Coal56AB/music_motor/docs/controller-architecture.md

# Музыкальная логика на STM32

STM32F103C8 выбирает до шести нот, отслеживает каналы и sustain, назначает моторы и вычисляет готовую индикацию. Логика индикации перенесена из ESP в `firmware/Core/Inc/display_overview.h` и исполняется только STM32; актуальное правило минимальной видимости описано ниже. ESP32 принимает USB-MIDI, хранит мелодии и рисует полученное состояние без таймеров нот. Компьютер сохраняет редактор и предварительный просмотр; аппаратное воспроизведение отправляет все допущенные настройками ноты, включая кандидатов, не выбранных предварительным просмотром.

Предельная частота STEP — 1200 Гц. Высокие живые ноты переносятся вниз по октавам. При подготовке файла компьютер применяет пользовательские фильтры партий, транспонирование и диапазон, сохраняет CC и ручные назначения. STM32 выполняет окончательный выбор голосов. Нативное ядро ограничено 128 одновременно учитываемыми экземплярами нот, включая педальные хвосты и повторные нажатия. При исчерпании памяти останавливает моторы с ошибкой, а не теряет Note Off.

## Буфер и время

При запуске из памяти ESP передаёт до 4 событий за RPC с учётом кредита STM. Увеличение до 16 вызвало отсутствие ACK на устройстве: допустимый размер пакета не гарантирует обработки MIDI в 3-миллисекундном окне ответа однопроводного UART. После подтверждённого завершённого префикса, покрывающего 500 мс от точки старта, можно запускать поток и пополнять его во время игры. Незавершённая группа MIDI не считается готовым префиксом. Отдельная задержка STM 100 мс сохраняется для предварительной индикации; сканирование диапазона нот файла также остаётся частью подготовки.

Ручные C_START/C_STOP сами включают/выключают ENABLE выбранного мотора. Это единая логика STM32 для терминала и экранчика. Отдельная команда C_ENABLE остаётся для проверки драйвера без STEP; при RESET/SLEEP запуск отклоняется до включения ENABLE.

Studio отправляет ручной START одной командой: ENABLE включается внутри STM перед запуском STEP. После STOP программа дополнительно отправляет C_ENABLE=0 для совместимости со старыми прошивками. C_STREAM_STOP и естественный конец файла всегда снимают ENABLE со всех моторов; прежний флаг «оставить ENABLE» игнорируется. Настройка отключения ENABLE после остановки убрана из интерфейса.

При загрузке/перемотке песни ни Studio, ни ESP не включают ENABLE заранее. STREAM_START оставляет драйверы выключенными во время стартовой задержки и тишины. Каждая команда Note On включает ENABLE непосредственно перед запуском таймера STEP, Note Off снимает его. Подтверждённый display_hold больше не зависит от физического ENABLE: экран может держать обозначение при обесточенном моторе. Для этого поведения обновляются обе прошивки и Studio.

Микрошаг — общая настройка контроллера. Запуск/перемотка песни с ПК и запуск сохранённой песни не отправляют C_MS. Старое поле raw в заголовках песен сохранено для совместимости формата, но при воспроизведении игнорируется. Значение меняется явным выбором в настройках (Studio также применяет свою настройку при подключении).

При назначении новых нот STM32 сохраняет занятые голоса, затем выбирает свободный мотор по расстоянию до его последней высоты, как старый распределитель Studio. Для ещё не использованного мотора расстояние нулевое. Это возвращает участие всех шести моторов в исходной демонстрации Clockwork при разрешённых M1–M6; сами ноты демонстрации не изменены.

Для файлов в режиме «Стабильное распределение» используется `file_assignment.h`: независимые экземпляры нот, включая унисоны разных партий, приоритеты по громкости/времени начала и перестановки назначения как в старом `allocator.place`. Clockwork сравнивается с прежним распределителем по каждому переключению всех шести моторов при пользовательском лимите полифонии 4, а не только по множеству задействованных моторов. Живой MIDI продолжает использовать отдельный алгоритм отбора высот.

Вместо двух больших музыкальных состояний STM32 использует один планировщик, работающий впереди воспроизведения. Принимает MIDI-события, выбирает голоса и помещает рассчитанные переключения в очередь из 512 записей по 8 байт (4096 байт). Частоты и времена хранятся без дополнительного округления. Маркеры времени сохраняют информацию о тишине. События исполняются по часам STM32, а не по моменту прихода пакета.

Компьютер старается наполнить очередь на 1,5 секунды вперёд; ESP перед стартом набирает до 2 секунд либо до исчерпания доступной ёмкости, затем пополняет все доступные места пакетами не более четырёх MIDI-событий. При заполненной очереди свободные места проверяются каждые 10 мс. ESP и Studio запрашивают ёмкость через C_QUEUE после очистки, поддерживая прежние контроллеры с 256 записями. Время покрытия зависит от плотности событий: фиксированная память не гарантирует 2 секунды на произвольном MIDI. Отсутствие будущей ноты в буфере не отменяет сглаживание индикации на STM32. Пустая очередь во время воспроизведения вызывает остановку с `E_UNDERRUN`.

При отпускании звучащего мотора STM32 ищет следующее назначение именно этому мотору. Если интервал не больше 500 мс, выставляет `display_hold`. STEP уже остановлен; экран сохраняет обозначение. При остановке, ошибке или потере связи удержание снимается. В живом MIDI будущего нет, поэтому `display_hold` не используется.

Для файлового/очередного воспроизведения минимальная длительность индикации равна 1000 мс от начала ноты. При длинной паузе нота, звучавшая не меньше секунды, гаснет сразу после отпускания; короткая остаётся только до `время начала + 1000`. Дополнительной секунды после отпускания нет. Началом считается включение или смена отображаемой ноты; подтверждённый `display_hold` сохраняет подсветку короткого промежутка. Сброс, сон, остановка и потеря связи гасят индикацию. На STEP и MIDI-график это сглаживание не влияет. Тесты проверяют короткие/длинные ноты, переполнение часов и передачу 100 000 готовых состояний STM на ESP. Старый алгоритм с дополнительной секундой изменён по запросу пользователя.

STATE v2 (86 байт) передаётся с интервалом 20 мс: первые 50 байт содержат фактическое состояние (version=2), следующие 36 — шесть готовых отображаемых записей `flags:u8, note:u8, frequency_mHz:u32`. Bit1 отображаемой записи означает подсветку, а не STEP. STM32 обновляет сглаживание при подготовке STATE; видимый момент изменения ограничен периодом передачи и временем доставки. ESP хранит эти значения до следующего STATE, кроме сброса при потере связи/смене источника. Нужно обновить обе платы. C_STATUS для ПК остаётся прежним; его данные не подменены отображаемыми.

## Формат событий

Базовый UART-протокол с CRC и ACK сохранён. Новые команды:

| Команда | Назначение |
|---|---|
| 22 `RAW_EVENTS` | Пакет MIDI-событий по 10 байт; ACK возвращает число доступных входных событий |
| 23 `RAW_SEEK` | 32-битная позиция перемотки в мс; до передачи событий, после CLEAR |
| 0x56 / 0x57 | Живые MIDI-события от ESP / подтверждение STM |

Запись: `uint32 time_ms`, `uint8 address`, `uint8 type`, `uint8 note`, `uint8 velocity`, `uint8 pin`, `uint8 priority`. Address содержит номер MIDI-порта в старших четырёх битах и канал в младших. Pin: 0 — автоматическое назначение; 1..6 — мотор. Priority 0..127 задаёт порядок редакторской партии для стратегии «Выбранные партии»; у живого MIDI, конфигурации, CC и конца файла он равен нулю.

Младшие семь бит type: 0 — Note On; 1 — Note Off; 2 — CC; 3 — конец файла; 4 — сброс живого MIDI; 5 — конфигурация файла. Старший бит завершает группу одновременных событий. Выбор выполняется после всей группы, даже если она разделена между пакетами. У конфигурации address — маска моторов, note — полифония 1..6, velocity — код стратегии. Конфигурация идёт первой, в момент 0. Конец файла — type 0x83, остальные поля нулевые.

На один входной MIDI-элемент резервируется до 13 выходных записей: шесть отпусканий, шесть включений и маркер. Дополнительный резерв нужен для восстановления при перемотке. Кредит рассчитывается как `max(0, floor((256-used)/13)-1)`. Отправитель передаёт не больше объявленного кредита. Неполный или неверный пакет отклоняется до изменения состояния; переполнение внутреннего пула нот приводит к явной остановке.

Для перемотки отправитель повторяет исходные события от начала, сохраняя абсолютные времена. STM32 анализирует префикс без STEP, восстанавливает состояние на границе перемотки и планирует оставшуюся часть относительно неё. ESP32 не вычисляет удержанные ноты.

Живой пакет содержит флаг подключения в первом байте и затем записи по 10 байт. ESP хранит неподтверждённый пакет и повторяет его с тем же номером. STM распознаёт повтор по полному содержимому и номеру: повторная доставка не создаёт дополнительного нажатия. Переполнение входной очереди ESP вызывает сброс музыкального состояния. Пока двигателями управляет компьютер или проигрыватель файла, живой источник получает ответ «занято».

## Совместимость и проверка

`SONG_BEGIN` длиной 49 байт с последним байтом 1 сохраняет новый формат. Заголовок Flash сохраняет прежний размер 64 байта; reserved=1 обозначает MIDI-события, reserved=0 — старые команды моторам. Новая ESP умеет читать оба формата. Старые файлы с частотой выше 1200 Гц надо сохранить заново. Симулятор ПК продолжает использовать предварительно рассчитанные команды; фактическое распределение на оборудовании и предварительный просмотр могут различаться.

Обе прошивки и программу ПК нужно обновлять вместе. Сборки не прошивают устройства и не запускают моторы. Перед испытанием проверяются нативные тесты реального `engine.c`: кольцевая очередь, sustain, перемотка, группы событий, выбор голосов, короткие паузы, тайм-аут и некорректные пакеты. Проверка времени обработки и джиттера STEP на физической плате остаётся отдельным измерением.
## Предварительная индикация

STATE v3 расширяет v2 до 94 байт: время STM `u32` по смещению 86 и поколение воспроизведения `u32` по смещению 90. ESP принимает также v1/v2. Пакет 0x45 содержит поколение `u32`, число записей `u8` и до 16 записей `at_STM:u32, motor:u8, note:u8, frequency_mHz:u32`. STM каждые 20 мс просматривает только уже назначенные выходные события ближайших 100 мс. Это не повторный анализ MIDI на ESP и не изменение времени STEP.

ESP хранит будущие включения индикаторов и исполняет их по времени STM. Смещение часов оценивается по минимальной наблюдаемой разнице времени приёма и метки STM в текущем поколении; задержка транспорта и LCD полностью не исключается. Запоздалый STATE не отменяет уже исполненное будущее включение. Начало, остановка и перемотка меняют поколение; смена источника также очищает очередь ESP. Выключение индикаторов по-прежнему рассчитывает STM прежним алгоритмом сглаживания. Живой MIDI и ноты, ещё не попавшие в буфер STM, заранее не предсказываются.

## Параметры и аккорд инициализации

ESP хранит подтверждённый STM микрошаг в записи настроек экрана (версия 2, CRC). Запись выполняется, как и для экрана, после 5 секунд без изменений, когда моторы остановлены. При загрузке ESP отправляет сохранённый шаг и ждёт подтверждения состояния до автоматической проверки моторов. Настройки версии 1 сохраняют свои параметры экрана; неверный CRC игнорируется. При подключённом ПК его настройки имеют приоритет.

Отрисовка узких индикаторов ограничена числом пикселей в буфере, а не фиксированными 16 строками: область 75×48 рисуется за один проход вместо трёх. Это не меняет временное сглаживание индикаторов на STM и не является предварительным планированием изображения.

STM последовательно добавляет C2–G3–E4–A4–D5–G5 с интервалом 400 мс. После вступления шестого мотора полный аккорд звучит 2000 мс, затем частоты линейно снижаются к 20 Гц за 400 мс с обновлением каждые 10 мс. После торможения STEP и ENABLE отключаются. От первой ноты до остановки проходит 4400 мс; экран ESP учитывает эту длительность. Принудительный стоп прерывает проверку и торможение немедленно.

## Независимость обмена от MIDI-графика ESP

Задача `song-control` на ядре 1 (приоритет 8) владеет разбором ACK, загрузкой
мелодии, пополнением STM, heartbeat и состоянием `control::Link`. Физический UART
по-прежнему обслуживает `stm-link` с приоритетом 21. LCD и touch работают в `hmi`
на ядре 0. `hmi_module_run` запускается после инициализации дисплея.

`ui_bridge` передаёт UI снимки каталога/состояния и до 128 полных графических
пакетов. Mutex удерживается только для копирования; экранные функции никогда не
вызываются под ним. Если UI надолго отстал, старая графическая история сбрасывается
и восстанавливается из следующих состояний. Поток нот не ждёт освобождения
экранной очереди. ACK экранного действия хранится отдельно и не вытесняется
телеметрией. Повтор команды запуска после задержки UI не переключает песню повторно.

Тест `native_ui_bridge_test.cpp` намеренно блокирует потребителя и проверяет,
что другой поток завершает публикацию 10 000 пакетов, сохраняет ACK/ошибку и
корректно обрабатывает смену источника и остановку. Это проверка синхронизации;
нагрузка на SPI и реальные интервалы задач проверяются на ESP.

UART-драйвер теперь устанавливается внутри `stm-link`: его ISR тоже получает
ядро 1, а не ядро UI, запустившее инициализацию. RX FIFO threshold — 32 байта,
RX timeout — 2 символа. USB role detection ждёт максимум 100 мс, завершаясь
раньше при обнаружении подключения. Обнаружение ПК после холодного включения
с таким коротким окном необходимо проверить на реальном USB-хосте.

История графика увеличена с 96 до 1024 записей. Открытые ноты не вытесняются;
при заполнении удаляется закрытая нота с наиболее старым окончанием. Предсказание,
которое старше последнего авторитетного STATE, не может снова зажечь столбик.

`desktop/tests/stress_saved_playback.py` проверяет реальный `song_store.cpp`,
`controller_link.cpp`, STM protocol/engine, ограниченные очереди и фрагментацию
ответов при 460800 baud. 200 прогонов пяти песен прошли без E10 и переполнения
TX: задержка ответа 1/10 мс, потери 0/10/25%, по 10 случайных последовательностей.
UI-потребитель в этой модели не обслуживается; отдельный threaded bridge test
проверяет отсутствие блокировки отправителя при зависшем UI. Это не измерение
запаса CPU на плате. Диагностический прогон с искусственными 50 мс на каждый обмен
воспроизводит E10: бесконечную задержку транспорта конечный буфер не компенсирует.

## Ответ до подготовки телеметрии

После повторной ошибки на устройстве найдено неучтённое моделью ограничение:
`protocol_esp_byte` вызывал `hmi_poll(1)` перед выдачей ответа. Расчёт preview и
истории входил в прежнее окно 3 мс. Теперь STM сначала формирует и запускает
ответ, затем готовит телеметрию для следующего обмена. Дополнительное ожидание
1 мс убрано: ESP сохраняет RX включённым во время TX и фильтрует эхо.
Согласованные параметры обеих плат: начало ответа не позднее 12 мс после запроса,
тайм-аут master 30 мс (запрос и ответ занимают суммарно менее 11 мс).
Просроченный запрос больше не очищает оставшуюся очередь ответов/телеметрии.

Регрессия `native_reply_order_test.c` вставляет 20 мс задержки в создание STATE
и проверяет, что вызов отправки ответа уже произошёл до неё. 200 прогонов песен
повторены с новым тайм-аутом; 33 теста desktop и 11 USB-симулятора прошли.
Исправления требуют перепрошивки STM и ESP вместе. Реальные интервалы выполнения
STM этим тестом не измеряются; отсутствие ошибок на плате ещё нужно подтвердить.

## Перегрузка телеметрии и диагностика живого MIDI

Очередь TX STM (`esp_tx_queue.h`) резервирует 64 байта под ACK (максимальный
ответ статуса — 61 байт). Отказ добавить экранный пакет больше не устанавливает
ошибку RX и не очищает входящие байты. Обе стороны этой очереди обслуживает
основной цикл, поэтому копирование не выключает прерывания STEP/UART; ISR
передаёт отдельный буфер HD-ответа.

`native_esp_tx_test.c`: 10 миллионов попыток добавить телеметрию, все ACK сохранены.
`native_live_spam_test.c`: 20 000 событий, переполнение номера последовательности,
30 секунд удержания одной ноты после потока и Note Off. 200 прогонов сохранённых
песен повторены с настоящей реализацией очереди TX, без переполнений и E10.
Это проверки кода; электрические потери UART и реальные времена ISR не моделируются.

ESP отправляет USB-симулятору пакет 0x61 с шестью uint32: запросы, ответы,
тайм-ауты, отброшенные RX-ответы, максимальная длительность обмена в микросекундах,
отказы очереди TX. Публикация выполняется задачей обмена раз в 500 мс и не зависит
от LCD. Симулятор показывает счётчики и убирает старую ошибку после переподключения.

На вкладке MIDI название выводится как `MIDI: <iProduct>` вместо сообщения о
подключении; отсутствие USB-названия заменяется на `USB MIDI`. Для симулятора —
`MIDI: USB-симулятор`. Имя хранится отдельно от очереди графика и переживает смену
источника и сброс отставшей отрисовки. Строка состояния не меняется.

## Текущие настройки отображения и курсора

Минимальное отображение ноты уменьшено до 200 мс от её начала. Удержание до
следующей известной ноты с паузой до 500 мс сохранено. Длительности STEP не меняются.
Например, нота длиной 600 мс перед паузой 600 мс теперь гаснет при окончании ноты,
а нота длиной 100 мс без ближайшего продолжения отображается до 200 мс.

В MIDI-редакторе одиночный левый щелчок в поле (включая ноты) устанавливает курсор
с привязкой к выбранной сетке. Решение принимается при отпускании кнопки:
перетаскивание нот, изменение длительности, выделение рамкой и Ctrl-выделение
не перемещают курсор. Установка курсора через верхнюю линейку сохранена.
