Coal56AB/music_motor/Songs/SOURCES.md

# Источники и обработка

## Рахманинов

Музыкальные данные двух прелюдий и их переложения в этой папке распространяются
по [CC BY-SA 4.0](https://creativecommons.org/licenses/by-sa/4.0/).

- **Прелюдия до-диез минор, op. 3 № 2**: Сергей Рахманинов; нотный набор Petro Kostandy,
  Mutopia-2015/07/09-2033. [Источник](https://www.mutopiaproject.org/cgibin/piece-info.cgi?id=2033).
  Издания Bosworth & Co. 1896 и Universal Edition 1910. Сохранены все разделы.
  Темп адаптирован: начальные низкие ноты (доли 0–6) — исходные 60 BPM,
  обе аккордовые части (6–54 и 178–218) — 50 BPM.
  Два протяжённых переходных аккорда после перебора (170–178) — 100 BPM.
  Перебор (54–170) и аутро (218–246) сохраняют исходные 192 и 62 BPM.
  Первые два звука вступления удлинены с 1 до 1,5 секунды каждый;
  третий начинается на секунду позже и заканчивается в исходный момент.
- **Прелюдия соль минор, op. 23 № 5**: Сергей Рахманинов; нотный набор Joram Berger,
  Mutopia-2015/09/28-2001. [Источник](https://www.mutopiaproject.org/cgibin/piece-info.cgi?id=2001).
  Взята первая маршевая часть до Un poco meno mosso (132 четвертные доли),
  добавлен заключительный аккорд соль минор.

Изменения для моторов: выбор максимум шести одновременно звучащих нот с приоритетом
мелодии и баса; перенос недоступных нот по октавам в диапазон 20–1200 Гц;
явные назначения M1–M6. Исходные MIDI и LilyPond сохранены в `sources/`.
Набор нот и паузы взяты из источников; изменения темпа указаны выше.
Это не запись исполнения пианиста.
Указание авторов не означает их одобрения этого переложения.

## Polyphia

Источник двух основных голосов — предоставленные пользователем массивы
`sources/polyphia_user_notes.txt`. Это фрагменты Playing God и O.D., расширенные
четырьмя разделами: исходный рифф, украшенная вариация, новая средняя часть
на начальном мотиве и возврат риффа с украшениями. Дополнительно вступают
арпеджио, синкопы, ответы и верхний голос.
Дополнительные партии и финал — новая аранжировка, а не восстановление полной записи группы.

Принятые допущения: ДО1 = C4, ДО0 = C3, СИ00 = B2; каждый исходный голос идёт
по собственным длительностям. Высокая мелодия Playing God перенесена целиком
на две октавы вниз; внутренние интервалы сохранены. Длительности звучания составляют
90% записанного шага для раздельных атак. Темпы аранжировок: Playing God 112 BPM,
O.D. 128 BPM. Это выбранные темпы для моторов, не заявленные темпы оригинальных записей.

## Имперский марш

Тема Джона Уильямса; новая моторная аранжировка. Высокое продолжение сверено
с [разбором и нотным фрагментом Music for Music Teachers](https://www.music-for-music-teachers.com/imperial-march-star-wars.html).
Форма: основная тема, высокое продолжение, его вариант с переходом, возвращение темы,
заключительный аккорд. Это переложение темы, не полная оркестровая партитура.

Пересоздание файлов: `python desktop/tools/build_music_examples.py`.
