Coal56AB/music_motor/Songs/sources/polyphia_user_notes.txt

static const MelodyStep_t Polyphia_OD_Notes[] = {
	// Второй голос: бас O.D., такты 41-44 и первая восьмая 45-го.
	// Заглушенные ноты (X) передаются паузами.
	// 1 ТАКТ / БАС: 41 ТАКТ
	{{FA1s, NOTE_SIXTEENTH}, {FA0s, NOTE_SIXTEENTH}},
	{{LA1, NOTE_SIXTEENTH}, {LA0, NOTE_SIXTEENTH}},
	{{DO2s, NOTE_SIXTEENTH}, {DO1s, NOTE_SIXTEENTH}},
	{{FA2s, NOTE_SIXTEENTH}, {FA1s, NOTE_SIXTEENTH}},
	{{NOTE_REST, NOTE_QUARTER}, {NOTE_REST, NOTE_QUARTER}},
  
	{{FA1s, NOTE_SIXTEENTH}, {NOTE_REST, NOTE_SIXTEENTH}},
	{{LA1, NOTE_SIXTEENTH}, {NOTE_REST, NOTE_SIXTEENTH}},
	{{DO2s, NOTE_SIXTEENTH}, {NOTE_REST, NOTE_SIXTEENTH}},
	{{RE2, NOTE_SIXTEENTH}, {NOTE_REST, NOTE_SIXTEENTH}},
	{{FA1, NOTE_SIXTEENTH}, {FA0, NOTE_SIXTEENTH}},
	{{SOL1s, NOTE_SIXTEENTH}, {FA0, NOTE_SIXTEENTH}},
	{{SI1, NOTE_SIXTEENTH}, {FA0, NOTE_SIXTEENTH}},
	{{FA2s, NOTE_SIXTEENTH}, {FA0, NOTE_SIXTEENTH}},

	// 2 ТАКТ / БАС: 42 ТАКТ
	{{FA2s, NOTE_SIXTEENTH}, {FA1, NOTE_SIXTEENTH}},
	{{SOL2s, NOTE_SIXTEENTH}, {FA1, NOTE_SIXTEENTH}},
	{{RE2, NOTE_SIXTEENTH}, {FA0, NOTE_SIXTEENTH}},
	{{SI1, NOTE_SIXTEENTH}, {FA0, NOTE_SIXTEENTH}},
	{{DO1s, NOTE_SIXTEENTH}, {FA0, NOTE_SIXTEENTH}},
	{{FA1, NOTE_SIXTEENTH}, {FA0, NOTE_SIXTEENTH}},
	{{SOL1s, NOTE_SIXTEENTH}, {NOTE_REST, NOTE_SIXTEENTH}},
	{{DO2s, NOTE_SIXTEENTH}, {NOTE_REST, NOTE_SIXTEENTH}},
	{{FA2, NOTE_THIRTYSECOND}, {NOTE_REST, NOTE_THIRTYSECOND}},
	{{FA2s, NOTE_THIRTYSECOND}, {NOTE_REST, NOTE_THIRTYSECOND}},
	{{FA2, NOTE_SIXTEENTH}, {NOTE_REST, NOTE_SIXTEENTH}},
	{{DO2s, NOTE_SIXTEENTH}, {NOTE_REST, NOTE_SIXTEENTH}},
	{{SI1, NOTE_SIXTEENTH}, {NOTE_REST, NOTE_SIXTEENTH}},
	{{SOL1s, NOTE_SIXTEENTH}, {NOTE_REST, NOTE_SIXTEENTH}},
	{{FA1, NOTE_SIXTEENTH}, {NOTE_REST, NOTE_SIXTEENTH}},
	{{DO3s, NOTE_SIXTEENTH}, {NOTE_REST, NOTE_SIXTEENTH}},

	// 3 ТАКТ / БАС: 43 ТАКТ
	{{FA1s, NOTE_SIXTEENTH}, {FA0s, NOTE_SIXTEENTH}},
	{{LA1, NOTE_SIXTEENTH}, {LA0, NOTE_SIXTEENTH}},
	{{DO2s, NOTE_SIXTEENTH}, {DO1s, NOTE_SIXTEENTH}},
	{{FA2s, NOTE_SIXTEENTH}, {FA1s, NOTE_SIXTEENTH}},  
	{{NOTE_REST, NOTE_QUARTER}, {NOTE_REST, NOTE_QUARTER}},
  
	{{FA1s, NOTE_SIXTEENTH}, {FA0s, NOTE_SIXTEENTH}},
	{{LA1, NOTE_SIXTEENTH}, {FA0s, NOTE_SIXTEENTH}},
	{{DO2s, NOTE_SIXTEENTH}, {FA0s, NOTE_SIXTEENTH}},
	{{RE2, NOTE_SIXTEENTH}, {FA0s, NOTE_SIXTEENTH}},
	{{FA1, NOTE_SIXTEENTH}, {FA0, NOTE_SIXTEENTH}},
	{{SOL1s, NOTE_SIXTEENTH}, {FA0, NOTE_SIXTEENTH}},
	{{SI1, NOTE_SIXTEENTH}, {FA0, NOTE_SIXTEENTH}},
	{{FA2s, NOTE_EIGHTH}, {FA0, NOTE_EIGHTH}},

	// 4 ТАКТ / БАС: 44 ТАКТ
	{{SOL2s, NOTE_SIXTEENTH}, {FA0, NOTE_SIXTEENTH}},
	{{RE2, NOTE_SIXTEENTH}, {FA0, NOTE_SIXTEENTH}},
	{{SI1, NOTE_SIXTEENTH}, {NOTE_REST, NOTE_SIXTEENTH}},
	{{LA1, NOTE_SIXTEENTH}, {FA0, NOTE_SIXTEENTH}},
	{{DO3s, NOTE_SIXTEENTH}, {FA0, NOTE_SIXTEENTH}},
	{{FA2s, NOTE_SIXTEENTH}, {FA0, NOTE_SIXTEENTH}},
	{{LA2, NOTE_SIXTEENTH}, {NOTE_REST, NOTE_SIXTEENTH}},
	{{SI1, NOTE_SIXTEENTH}, {NOTE_REST, NOTE_SIXTEENTH}},
	{{SI0, NOTE_SIXTEENTH}, {NOTE_REST, NOTE_SIXTEENTH}},
	{{RE2, NOTE_SIXTEENTH}, {FA0s, NOTE_SIXTEENTH}},
	{{SOL2s, NOTE_SIXTEENTH}, {FA0s, NOTE_SIXTEENTH}},
	{{LA1, NOTE_SIXTEENTH}, {DO1s, NOTE_SIXTEENTH}},
	{{DO1s, NOTE_SIXTEENTH}, {DO1s, NOTE_SIXTEENTH}},
	{{LA2, NOTE_SIXTEENTH}, {SI00, NOTE_SIXTEENTH}},
	{{FA2s, NOTE_SIXTEENTH}, {NOTE_REST, NOTE_SIXTEENTH}},

	// 5 ТАКТ / БАС: НАЧАЛО 45 ТАКТА
	{{SI1, NOTE_SIXTEENTH}, {SI00, NOTE_SIXTEENTH}},
	{{RE2, NOTE_SIXTEENTH}, {SI00, NOTE_SIXTEENTH}},
	{{FA2s, NOTE_SIXTEENTH}, {SI00, NOTE_SIXTEENTH}},
	{{SI2, NOTE_SIXTEENTH}, {SI00, NOTE_SIXTEENTH}}
};
static Melody_t Polyphia_OD = {
	song_length(Polyphia_OD_Notes), Polyphia_OD_Notes, {10U, 2U}
};

static const MelodyStep_t Polyphia_PlayingGod_Notes[] = {
	//1 ТАКТ
	{{SOL2, NOTE_QUARTER}, {MI0, NOTE_EIGHTH}},
	{{MI3, NOTE_EIGHTH}, {MI0, NOTE_EIGHTH}},
	{{SI3, NOTE_EIGHTH}, {MI0, NOTE_EIGHTH}},
	{{MI4, NOTE_EIGHTH}, {MI0, NOTE_EIGHTH}},
	{{SI3, NOTE_EIGHTH}, {NOTE_REST, NOTE_EIGHTH}},
	{{SOL3, NOTE_EIGHTH}, {NOTE_REST, NOTE_EIGHTH}},
	{{SI3, NOTE_EIGHTH}, {MI0, NOTE_EIGHTH}},
	{{DO4, NOTE_EIGHTH_DOT}, {MI0, NOTE_EIGHTH}},
	{{LA3, NOTE_SIXTEENTH}, {DO1, NOTE_EIGHTH}},
	{{SI3, NOTE_EIGHTH}, {DO1, NOTE_EIGHTH}},
	{{SI2, NOTE_EIGHTH_DOT}, {DO0, NOTE_EIGHTH}},
	{{DO2, NOTE_SIXTEENTH}, {DO0, NOTE_EIGHTH}},
	{{SI3, NOTE_EIGHTH}, {NOTE_REST, NOTE_EIGHTH}},
	{{MI3, NOTE_QUARTER}, {NOTE_REST, NOTE_EIGHTH}},
	
	//2 ТАКТ
	{{RE3s, NOTE_QUARTER}, {NOTE_REST, NOTE_EIGHTH}},
	{{SI2, NOTE_EIGHTH}, {MI1, NOTE_SIXTEENTH}},
	{{LA2, NOTE_EIGHTH}, {MI1, NOTE_SIXTEENTH}},
	{{LA3, NOTE_EIGHTH}, {SI00, NOTE_EIGHTH}},
	{{SI3, NOTE_SIXTEENTH}, {SI00, NOTE_EIGHTH}},
	{{LA3, NOTE_EIGHTH}, {SI00, NOTE_EIGHTH}},
	{{RE3, NOTE_SIXTEENTH}, {SI00, NOTE_EIGHTH}},
	{{FA4s, NOTE_SIXTEENTH}, {NOTE_REST, NOTE_EIGHTH}},
	{{LA4, NOTE_SIXTEENTH}, {NOTE_REST, NOTE_EIGHTH}},
	{{RE3s, NOTE_EIGHTH}, {LA0, NOTE_EIGHTH}},
	{{LA3, NOTE_SIXTEENTH}, {LA0, NOTE_SIXTEENTH}},
	{{RE3s, NOTE_EIGHTH}, {LA0, NOTE_SIXTEENTH}},
	
	{{SI4, NOTE_SIXTEENTH}, {SI00, NOTE_EIGHTH}},
	{{FA4s, NOTE_SIXTEENTH}, {SI00, NOTE_EIGHTH}},
	{{RE3s, NOTE_THIRTYSECOND}, {SI00, NOTE_EIGHTH}},
	{{NOTE_REST, NOTE_THIRTYSECOND}, {SI00, NOTE_EIGHTH}},
	{{RE3s, NOTE_EIGHTH}, {SOL0, NOTE_EIGHTH_TRIPLET}},
	{{MI3, NOTE_EIGHTH}, {SOL0, NOTE_EIGHTH_TRIPLET}},
	
	{{DO3, NOTE_SIXTEENTH}, {SI0, NOTE_QUARTER_TRIPLET}},
	{{SI2, NOTE_SIXTEENTH}, {SOL0, NOTE_EIGHTH_TRIPLET}},
	{{MI3, NOTE_SIXTEENTH}, {SOL0, NOTE_EIGHTH_TRIPLET}},
};
