Coal56AB/music_motor/docs/images/music-motor-studio_midi.png

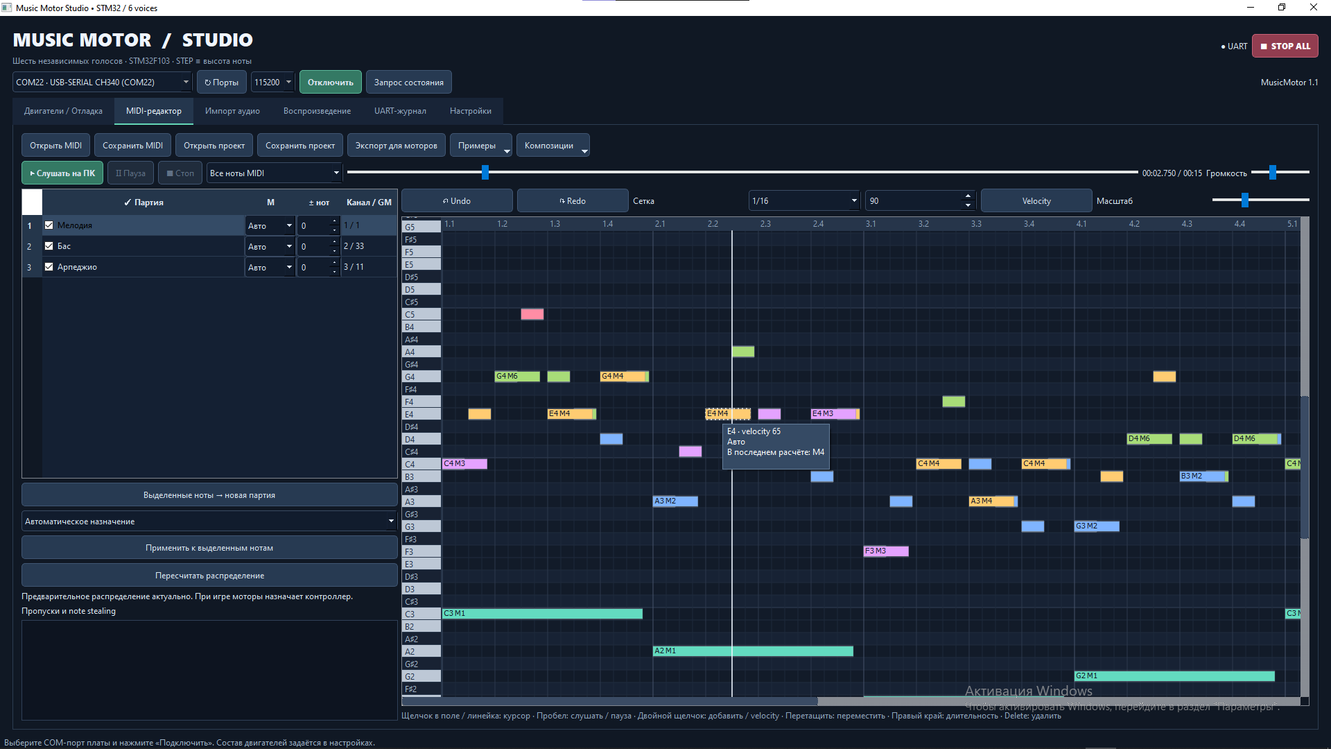
docs/images/music-motor-studio_midi.png
