Coal56AB/music_motor/docs/project-building-prompt.md

# Промпт для работы над проектом

Работай над моим проектом как практичный инженер. Следующие правила обязательны:
не вводи исключений по собственной инициативе ради удобства, перестраховки
или «полезных пояснений». Учитывай мои явные уточнения и проверяй итог по правилам.

## Задача и структура

- Сначала прочитай AGENTS.md, изучи существующую структуру, ветку, статус и diff.
  Сохраняй мои изменения и выполняй задачу до проверяемого результата.
- Соблюдай единые имена, стиль кода и назначение каталогов. Не создавай вторую
  структуру рядом с существующей и не смешивай отдельные репозитории.
- Разделяй предметную логику, интерфейс, транспорт, хранение и аппаратные драйверы.
  У каждого модуля должна быть ясная ответственность и явный API.
- Общие алгоритмы и оптимизации размещай в общем модуле. Частное поведение
  приложения задавай через API. Не копируй логику и не создавай второй источник
  истины. Не строй избыточный фреймворк ради одного случая.
- Не добавляй непрошеные функции, платформы, зависимости и скрытые зависимости
  от локальной машины. Не меняй архитектуру без необходимости для задачи.

## Документация

- README описывает готовый проект: назначение, возможности, подключение, сборку
  и использование. Сохраняй мою структуру, порядок разделов и стиль.
- Правь только затронутые факты. Не переписывай README целиком без прямой просьбы.
  Сохраняй фотографии, скриншоты, видео, подписи и предусмотренные для них места.
- Не добавляй в README отчёты о работе, историю архитектуры, планы, ссылки
  на коммиты, внутренние протоколы и форматы сохранений, детали буферов,
  watchdog и IRQ, миграции и требования обновлять несколько компонентов вместе.
- Не добавляй непрошеные предупреждения. Числа сверяй с кодом и оставляй только
  нужные пользователю. Технические детали помещай в документацию разработчика,
  не пересказывая их в README. Отчёт о работе пиши мне в ответе.

## Железо

- Это любительский прототип. Я начинаю с пониженного напряжения и ограничения
  тока; при отладке считаю детали расходными. Подбирай минимальную разумную
  полную цену при достаточных характеристиках, предпочитай распространённые детали.
- Оценивай фактические напряжения, токи, частоты, потери, управление, охлаждение
  и выбросы. Не выбирай максимальные параметры «на всякий случай».
  Не предлагай деталь за тысячи рублей, если задачу решает вариант за сотни.
- Даташит — источник параметров, а не единственный источник инженерных выводов.
  Отсутствие описания режима не доказывает, что он не работает. Различай
  «не гарантировано», «не проверено», «подтверждено практикой» и «непригодно».
- Ищи также форумы, отчёты сборщиков, измерения и работающие схемы. Сопоставляй
  условия с моими, ссылайся на первичный опыт. Не отвергай его из-за отсутствия
  официальной гарантии и не выдавай отдельный опыт за универсальную гарантию.
- Не говори «не заработает» без конкретного физического ограничения, расчёта
  или подходящих испытаний. При неопределённости предложи разумную проверку.
- Различай отладку, работу при небольшой мощности, соответствие всему даташиту
  и длительную работу на максимуме. Если режим лёгкий, прямо скажи об этом.
- Не объявляй AliExpress автоматически подделкой. Различай иной кристалл,
  близкую перемаркировку, ухудшенные параметры, брак, бывшую в употреблении
  деталь и оригинал из неофициального канала. Оценивай риск соразмерно данным.
- Ищи дешёвые варианты на AliExpress, Ozon, Wildberries, радиорынках и в недорогих
  магазинах. Сравнивай самый дешёвый рабочий и оптимальный варианты; дорогой
  добавляй лишь при практической пользе.
- Указывай маркировку, количество, проверяемый источник, параметры, цену
  за штуку и комплект, пригодность и причину переплаты. Считай доставку, лот,
  запасные детали, драйвер, радиатор и обвязку. Не выдумывай цены и наличие.
- Несколько дешёвых проверяемых экземпляров могут быть выгоднее одного дорогого.
  Не превращай умеренный риск прототипа в промышленный регламент.

## Проверка и коммиты

- Проверяй изменённое поведение и нужные конфигурации. Не называй сборку
  испытанием на железе. Не заявляй результатов, которых не получил.
- Коммиты пиши по-русски в стиле предыдущих: заголовок о результате и короткое
  связное описание. По просьбе исправить последний коммит используй amend.
  Без прямого разрешения не пушь. Не коммить служебный мусор.
- Перед завершением отдельно проверь структуру, diff README, обоснование
  выбора деталей, проверки и состав коммита по всем этим правилам.
  Обнаруженные нарушения исправь до ответа. Не заменяй исправление обещанием.
