Coal56AB/music_motor/desktop/app/main_window.py

import copy
import datetime
import struct
import time
from pathlib import Path
from PySide2.QtCore import Qt, QTimer, QObject, QThread, Signal
from PySide2.QtWidgets import (
    QMainWindow,
    QWidget,
    QVBoxLayout,
    QHBoxLayout,
    QGridLayout,
    QLabel,
    QPushButton,
    QComboBox,
    QCheckBox,
    QTabWidget,
    QGroupBox,
    QScrollArea,
    QSplitter,
    QTableWidget,
    QTableWidgetItem,
    QHeaderView,
    QFileDialog,
    QMessageBox,
    QSpinBox,
    QDoubleSpinBox,
    QSlider,
    QPlainTextEdit,
    QProgressBar,
    QFormLayout,
    QLineEdit,
    QInputDialog,
    QShortcut,
    QMenu,
    QFrame,
)
from serial.tools import list_ports
from app.settings import load_settings, save_settings, ROOT, songs_directory
from app.music_math import MICROSTEPS, note_name, note_frequency
from app.playback import StreamPlayer, short_gap_note
from app.device_songs import DeviceSongs
from app.theme import STYLE
from widgets.motor_card import MotorCard
from widgets.midi_overview import MidiOverview
from widgets.piano_roll import PianoRoll, NoteItem
from protocol.client import Client
from protocol.wire import Command as C, Error
from midi.model import load_midi, save_midi, demo_song, save_project, load_project, Part, Song, Note
from midi.library import discover_songs
from midi.allocator import allocate, pin_conflict_spans, STRATEGIES, MOTOR_COLORS
from audio.transcribe import transcribe
from audio.preview import PreviewPlayer, preview_notes


def button(text, slot, kind=None):
    b = QPushButton(text)
    b.clicked.connect(slot)
    if kind:
        b.setObjectName(kind)
    return b


def spin(low, high, value):
    w = QSpinBox()
    w.setRange(low, high)
    w.setValue(value)
    return w


class AudioWorker(QObject):
    done = Signal(object)
    failed = Signal(str)
    progress = Signal(int)
    finished = Signal()

    def __init__(self, path, options):
        super().__init__()
        self.path = path
        self.options = options

    def run(self):
        try:
            self.done.emit(transcribe(self.path, progress=self.progress.emit, **self.options))
        except Exception as exc:
            self.failed.emit(str(exc))
        finally:
            self.finished.emit()


class MainWindow(QMainWindow):
    def __init__(self, settings_path=None, auto_connect=False, simulation=False):
        super().__init__()
        self.settings_path = settings_path
        self.config = load_settings(settings_path)
        self.simulation = simulation  # Injected only by service tests, never from saved settings.
        self.setWindowTitle("Music Motor Studio • STM32 / 6 voices")
        self.resize(1280, 930)
        self.setMinimumSize(1000, 700)
        self.setStyleSheet(STYLE)
        self.latest_status = None
        self.link_error = False
        self.allocation = None
        self.allocation_dirty = True
        self.loading = False
        self.audio_thread = None
        self.audio_song = None
        self.client = Client(self)
        self.player = StreamPlayer(self.client, self)
        self.player.before_start = self.update_device_screen
        self.screen_action_ack = 0
        self.screen_timer = QTimer(self)
        self.screen_timer.timeout.connect(self.update_device_screen)
        self.screen_timer.start(100)
        self.client.connection.connect(lambda _: setattr(self, 'screen_action_ack', 0))
        self.preview = PreviewPlayer(self)
        self.preview_cursor_beat = 0.0
        self.main_cursor_ms = 0
        self.direction_epoch = 0
        self.direction_motor_epochs = [0] * 6
        self.direction_restart = [False] * 6
        self.song = demo_song()
        outer = QWidget()
        self.setCentralWidget(outer)
        root = QVBoxLayout(outer)
        root.setContentsMargins(18, 14, 18, 8)
        head = QHBoxLayout()
        heading = QVBoxLayout()
        title = QLabel("MUSIC MOTOR  /  STUDIO")
        title.setObjectName("title")
        subtitle = QLabel("Шесть независимых голосов · STM32F103 · STEP ≡ высота ноты")
        subtitle.setObjectName("subtitle")
        heading.addWidget(title)
        heading.addWidget(subtitle)
        head.addLayout(heading, 1)
        self.connection_label = QLabel("○ Отключено")
        head.addWidget(self.connection_label)
        head.addWidget(button("■  STOP ALL", self.stop_all, "danger"))
        root.addLayout(head)
        link = QHBoxLayout()
        self.ports = QComboBox()
        self.ports.setMinimumWidth(155)
        self.ports.setMaximumWidth(260)
        self.baud = QComboBox()
        self.baud.addItems(["115200", "57600", "230400"])
        self.baud.setCurrentText(str(self.config["baudrate"]))
        self.connect_button = button("Подключить", self.toggle_connection, "primary")
        for w in [
            self.ports,
            button("↻ Порты", self.refresh_ports),
            self.baud,
            self.connect_button,
            button(
                "Запрос состояния",
                lambda: self.client.send(C.GET_STATUS, callback=self.receive_status_bytes),
            ),
        ]:
            link.addWidget(w)
        link.addStretch()
        self.version = QLabel("Прошивка —")
        link.addWidget(self.version)
        root.addLayout(link)
        self.notice = QFrame()
        self.notice.setObjectName('errorNotice')
        notice_row = QHBoxLayout(self.notice)
        notice_text = QVBoxLayout()
        self.notice_title = QLabel()
        self.notice_title.setObjectName('noticeTitle')
        self.notice_message = QLabel()
        self.notice_hint = QLabel()
        for label in (self.notice_title, self.notice_message, self.notice_hint):
            label.setTextFormat(Qt.PlainText)
            label.setWordWrap(True)
            label.setTextInteractionFlags(Qt.TextSelectableByMouse)
            notice_text.addWidget(label)
        notice_row.addLayout(notice_text, 1)
        notice_row.addWidget(button('UART-журнал', lambda: self.tabs.setCurrentWidget(self.log.parentWidget())))
        notice_row.addWidget(button('Закрыть', self.notice.hide))
        root.addWidget(self.notice)
        self.notice.hide()
        self.tabs = QTabWidget()
        root.addWidget(self.tabs, 1)
        self.build_motors()
        self.build_editor()
        self.build_audio()
        self.build_playback()
        self.build_log()
        self.build_settings()
        self.client.status.connect(self.on_status)
        self.client.info.connect(self.show_version)
        self.client.log.connect(self.append_log)
        self.client.fault.connect(self.show_error)
        self.client.connection.connect(self.on_connection)
        self.client.fault.connect(lambda *_args: self.cancel_direction_restart())
        self.player.changed.connect(self.player_state)
        self.player.progress.connect(self.on_progress)
        self.player.failed.connect(self.show_error)
        self.preview.changed.connect(self.preview_state)
        self.preview.progress.connect(self.preview_progress)
        self.preview.failed.connect(lambda message: self.show_notice('Ошибка прослушивания', message,
            'Проверьте выбранное устройство вывода звука и повторите прослушивание.'))
        self.set_song(self.song)
        self.refresh_ports()
        self.on_connection(False)
        self.statusBar().showMessage(
            "Выберите COM-порт платы и нажмите «Подключить». Состав двигателей задаётся в настройках."
        )
        if auto_connect:
            QTimer.singleShot(0, self.toggle_connection)

    def page(self, title):
        widget = QWidget()
        layout = QVBoxLayout(widget)
        layout.setContentsMargins(12, 12, 12, 12)
        self.tabs.addTab(widget, title)
        return widget, layout

    def build_motors(self):
        page, root = self.page("Двигатели / Отладка")
        scroll = self.motor_scroll = QScrollArea()
        self.midi_overview = MidiOverview()
        self.midi_overview.seek_requested.connect(lambda *_args: self.seek_main_cursor(self.midi_overview.position_ms))
        scroll.setWidgetResizable(True)
        content = QWidget()
        grid = self.motor_grid = QGridLayout(content)
        grid.setSpacing(10)
        self.cards = []
        for i in range(6):
            card = MotorCard(i, self.config, content)
            card.command.connect(self.manual_command)
            self.cards.append(card)
        self.no_motors = QLabel("Двигатели не выбраны. Откройте «Настройки» и укажите используемые моторы.", content)
        self.no_motors.setWordWrap(True)
        self.layout_motors()
        scroll.setWidget(content)
        root.addWidget(scroll, 1)
        transport = QHBoxLayout()
        self.main_play_button = button("▶ Мелодия", lambda *_args: self.toggle_main_playback(), "primary")
        self.main_stop_button = button("■ Стоп", lambda *_args: self.stop_all())
        self.main_song_label = QLabel()
        self.main_play_button.setToolTip("Воспроизвести текущую мелодию на двигателях / пауза")
        transport.addWidget(self.main_play_button)
        transport.addWidget(self.main_stop_button)
        transport.addWidget(self.main_song_label, 1)
        root.addLayout(transport)
        root.addWidget(self.midi_overview, 1)
        self.common = QGroupBox("Общие сигналы для ВСЕХ шести драйверов")
        self.common.setObjectName("commonSignals")
        row = QGridLayout(self.common)
        row.setHorizontalSpacing(10)
        self.micro = QComboBox()
        for name, (raw, factor) in MICROSTEPS.items():
            self.micro.addItem(name, (raw, factor))
        self.micro.activated[int].connect(lambda *_args: self.micro_selected())
        current = next(
            (
                i
                for i in range(self.micro.count())
                if self.micro.itemData(i)[0] == self.config["microstep_raw"]
            ),
            0,
        )
        self.micro.setCurrentIndex(current)
        self.sleep = QCheckBox("SLEEP активен")
        self.reset = QCheckBox("RESET активен")
        self.sleep.clicked.connect(self.sleep_clicked)
        self.reset.clicked.connect(self.reset_clicked)
        self.reset_button = button("RESET", self.reset_drivers)
        self.reset_button.setToolTip("Остановить все STEP, выключить все ENABLE и включить общий RESET.")
        self.activate_button = button("ACTIVATE", self.activate_drivers, "primary")
        self.reset_button.setProperty("commonAction", True)
        self.activate_button.setProperty("commonAction", True)
        self.activate_button.setToolTip("Снять общие RESET и SLEEP. Кнопка «Пуск» включает ENABLE и STEP.")
        self.reset_button.setMinimumHeight(36)
        self.activate_button.setMinimumHeight(36)
        self.reset_button.setMinimumWidth(110)
        self.activate_button.setMinimumWidth(120)
        for column, w in enumerate((self.micro, self.sleep, self.reset, self.reset_button, self.activate_button)):
            row.addWidget(w, 0, column)
        row.setColumnStretch(0, 1)
        row.setContentsMargins(12, 6, 12, 8)
        self.common_manual_controls = [self.micro, self.sleep, self.reset]
        root.addWidget(self.common)
        hint = QLabel(
            "A4988: полный / ½ / ¼ / ⅛ / ¹⁄₁₆. Таблицу конкретного HR4998 сверьте с документацией модуля. RPM — расчёт, датчика вращения нет."
        )
        hint.setWordWrap(True)
        hint.setObjectName("subtitle")
        root.addWidget(hint)

    def build_editor(self):
        page, root = self.page("MIDI-редактор")
        self.preview_shortcut = QShortcut("Space", page)
        self.preview_shortcut.setContext(Qt.WidgetWithChildrenShortcut)
        self.preview_shortcut.setAutoRepeat(False)
        self.preview_shortcut.activated.connect(self.toggle_preview)
        tools = QHBoxLayout()
        for text, slot in [
            ("Открыть MIDI", self.open_midi),
            ("Сохранить MIDI", self.save_midi),
            ("Открыть проект", self.open_project),
            ("Сохранить проект", self.save_project),
        ]:
            tools.addWidget(button(text, slot))
        tools.addWidget(button("Экспорт для моторов", self.export_arrangement))
        examples_button=QPushButton("Примеры")
        examples_menu=QMenu(examples_button)
        examples_menu.addAction("Clockwise").triggered.connect(lambda *_: self.set_song(demo_song()))
        examples_button.setMenu(examples_menu)
        tools.addWidget(examples_button)
        self.songs_button = QPushButton("Композиции")
        self.songs_menu = QMenu(self.songs_button)
        self.songs_menu.aboutToShow.connect(self.refresh_songs_menu)
        self.songs_button.setMenu(self.songs_menu)
        tools.addWidget(self.songs_button)
        tools.addStretch()
        root.addLayout(tools)
        self.preview_controls = QWidget()
        listen = QHBoxLayout(self.preview_controls)
        listen.setContentsMargins(0, 0, 0, 0)
        self.listen_button = button("▶ Слушать на ПК", self.listen, "primary")
        self.listen_pause = button("Ⅱ Пауза", self.preview.pause_resume)
        self.listen_stop = button("■ Стоп", self.preview.stop)
        self.listen_mode = QComboBox()
        self.listen_mode.addItems(["Все ноты MIDI", "Как распределено по моторам"])
        self.listen_mode.setToolTip(
            "Все ноты: включённые партии, без ограничения числа голосов.\n"
            "По моторам: с пропусками, переносом октав и прерываниями.\n"
            "Простой синтезированный тембр для проверки нот; без GM-инструментов.")
        self.listen_mode.currentIndexChanged.connect(lambda *_args: self.preview.stop())
        self.listen_seek = QSlider(Qt.Horizontal)
        self.listen_seek.setRange(0, 1000)
        self.listen_seek.setMinimumWidth(90)
        self.listen_seek.sliderReleased.connect(self.seek_preview_slider)
        self.listen_time = QLabel("00:00 / 00:00")
        self.listen_volume = QSlider(Qt.Horizontal)
        self.listen_volume.setRange(0, 100)
        self.listen_volume.setValue(35)
        self.listen_volume.setMaximumWidth(90)
        self.listen_volume.setToolTip("Громкость звука компьютера")
        self.listen_volume.valueChanged.connect(lambda *_args: self.preview.set_volume(self.listen_volume.value()))
        for w in (self.listen_button, self.listen_pause, self.listen_stop, self.listen_mode):
            listen.addWidget(w)
        listen.addWidget(self.listen_seek, 1)
        listen.addWidget(self.listen_time)
        listen.addWidget(QLabel("Громкость"))
        listen.addWidget(self.listen_volume)
        self.listen_pause.setEnabled(False)
        self.listen_stop.setEnabled(False)
        self.listen_seek.setEnabled(False)
        root.addWidget(self.preview_controls)
        split = QSplitter(Qt.Horizontal)
        left = QWidget()
        ll = QVBoxLayout(left)
        ll.setContentsMargins(0, 0, 0, 0)
        self.parts = QTableWidget(0, 4)
        self.parts.setHorizontalHeaderLabels(["✓ Партия", "M", "± нот", "Канал / GM"])
        self.parts.horizontalHeader().setSectionResizeMode(0, QHeaderView.Stretch)
        self.parts.setColumnWidth(1, 75)
        self.parts.setColumnWidth(2, 65)
        self.parts.setColumnWidth(3, 80)
        self.parts.setMinimumWidth(320)
        self.parts.itemChanged.connect(self.part_changed)
        self.parts.itemSelectionChanged.connect(self.part_selected)
        ll.addWidget(self.parts)
        ll.addWidget(button("Выделенные ноты → новая партия", self.split_part))
        self.note_motor = QComboBox()
        self.note_motor.addItem('Автоматическое назначение', -1)
        for motor in range(6):
            self.note_motor.addItem('Закрепить за M%d' % (motor + 1), motor)
        ll.addWidget(self.note_motor)
        ll.addWidget(button('Применить к выделенным нотам',
                            lambda: self.roll.assign_selected(self.note_motor.currentData())))
        ll.addWidget(button('Пересчитать распределение', self.reallocate))
        self.editor_allocation_status = QLabel('')
        self.editor_allocation_status.setWordWrap(True)
        ll.addWidget(self.editor_allocation_status)
        self.skip_list = QPlainTextEdit()
        self.skip_list.setReadOnly(True)
        self.skip_list.setMaximumHeight(145)
        ll.addWidget(QLabel("Пропуски и note stealing"))
        ll.addWidget(self.skip_list)
        split.addWidget(left)
        right = QWidget()
        rl = QVBoxLayout(right)
        rl.setContentsMargins(0, 0, 0, 0)
        edit = QHBoxLayout()
        self.roll = PianoRoll()
        self.roll.edited.connect(self.on_edited)
        self.roll.cursor_changed.connect(self.set_preview_cursor)
        self.undo_button = button("↶ Undo", lambda *_args: self.roll.undo_stack.undo())
        self.redo_button = button("↷ Redo", lambda *_args: self.roll.undo_stack.redo())
        edit.addWidget(self.undo_button)
        edit.addWidget(self.redo_button)
        self.snap = QComboBox()
        for name, value in [("1/4", 1), ("1/8", 0.5), ("1/16", 0.25), ("1/32", 0.125)]:
            self.snap.addItem(name, value)
        self.snap.setCurrentIndex(2)
        self.snap.currentIndexChanged.connect(self.snap_selected)
        edit.addWidget(QLabel("Сетка"))
        edit.addWidget(self.snap)
        self.velocity = spin(1, 127, 90)
        edit.addWidget(self.velocity)
        edit.addWidget(button("Velocity", self.set_velocity))
        zoom = QSlider(Qt.Horizontal)
        zoom.setRange(25, 180)
        zoom.setValue(76)
        zoom.setMaximumWidth(140)
        zoom.valueChanged.connect(self.roll.set_zoom)
        self.roll.zoom_changed.connect(zoom.setValue)
        edit.addWidget(QLabel("Масштаб"))
        edit.addWidget(zoom)
        rl.addLayout(edit)
        rl.addWidget(self.roll, 1)
        hint = QLabel(
            "Щелчок в поле / линейка: курсор · Пробел: слушать / пауза · Двойной щелчок: добавить / velocity · Перетащить: переместить · Правый край: длительность · Delete: удалить"
        )
        hint.setWordWrap(True)
        hint.setObjectName("subtitle")
        rl.addWidget(hint)
        split.addWidget(right)
        split.setSizes([340, 820])
        root.addWidget(split, 1)
        self.editor_tool_layouts = [tools, edit]

    def build_audio(self):
        page, root = self.page("Импорт аудио")
        title = QLabel("Аудиозапись → ноты → редактирование")
        title.setStyleSheet("font-size:22px;font-weight:600")
        root.addWidget(title)
        warning = QLabel(
            "Распознавание приблизительное. Сложный микс, вокал, ударные и гармоники могут давать ошибки.\nСпектральный анализ не разделяет запись на реальные инструменты; исправляйте результат в piano roll."
        )
        warning.setWordWrap(True)
        warning.setObjectName('warningText')
        root.addWidget(warning)
        form = QFormLayout()
        self.audio_path = QLineEdit()
        r = QHBoxLayout()
        r.addWidget(self.audio_path)
        r.addWidget(button("Выбрать файл", self.choose_audio))
        form.addRow("WAV / MP3 / FLAC / OGG", r)
        self.audio_engine = QComboBox()
        self.audio_engine.addItem("Спектральные пики · доступен сразу", "spectral")
        self.audio_engine.addItem("librosa pYIN · одна нота", "pyin")
        self.audio_engine.addItem("Basic Pitch · внешний движок", "basic_pitch")
        form.addRow("Алгоритм", self.audio_engine)
        self.audio_poly = spin(1, 6, 4)
        form.addRow("Максимум одновременных нот", self.audio_poly)
        self.minimum_duration = QDoubleSpinBox()
        self.minimum_duration.setRange(0.03, 2)
        self.minimum_duration.setSingleStep(0.01)
        self.minimum_duration.setValue(0.1)
        self.minimum_duration.setSuffix(" с")
        form.addRow("Минимальная длительность", self.minimum_duration)
        self.sensitivity = QDoubleSpinBox()
        self.sensitivity.setRange(0.05, 1)
        self.sensitivity.setSingleStep(0.05)
        self.sensitivity.setValue(0.25)
        form.addRow("Порог (меньше → больше нот)", self.sensitivity)
        self.audio_low, self.audio_high = QComboBox(), QComboBox()
        names = ("до", "до♯", "ре", "ре♯", "ми", "фа", "фа♯", "соль", "соль♯", "ля", "ля♯", "си")
        for control, default in ((self.audio_low, 36), (self.audio_high, 96)):
            for n in range(128):
                control.addItem("%s · %s · %s Гц" %
                                (note_name(n), names[n % 12], ("%.2f" % note_frequency(n)).replace('.', ',')), n)
            control.setCurrentIndex(control.findData(default))
        limits = QHBoxLayout()
        limits.addWidget(QLabel("От"))
        limits.addWidget(self.audio_low)
        limits.addWidget(QLabel("до"))
        limits.addWidget(self.audio_high)
        limits.setStretch(1, 1)
        limits.setStretch(3, 1)
        form.addRow("Диапазон распознаваемых нот", limits)
        root.addLayout(form)
        actions = QHBoxLayout()
        self.analyze_button = button("Распознать ноты", self.analyze_audio, "primary")
        actions.addWidget(self.analyze_button)
        self.audio_accept = button("Перенести в MIDI-редактор", self.accept_audio)
        self.audio_accept.setEnabled(False)
        actions.addWidget(self.audio_accept)
        actions.addWidget(button("Сохранить промежуточный MIDI", self.save_audio_midi))
        actions.addStretch()
        root.addLayout(actions)
        self.audio_progress = QProgressBar()
        root.addWidget(self.audio_progress)
        self.audio_preview = PianoRoll()
        self.audio_preview.read_only = True
        root.addWidget(self.audio_preview, 1)

    def build_playback(self):
        page, root = self.page("Воспроизведение")
        self.song_label = QLabel()
        self.song_label.setStyleSheet("font-size:24px;font-weight:600")
        root.addWidget(self.song_label)
        box = QGroupBox("Распределение нот")
        form = QFormLayout(box)
        self.strategy = QComboBox()
        for key, name in STRATEGIES.items():
            self.strategy.addItem(name, key)
        self.strategy.setCurrentIndex(max(0, self.strategy.findData(self.config["strategy"])))
        form.addRow("Стратегия", self.strategy)
        self.poly = spin(1, 6, self.config["max_polyphony"])
        form.addRow("Максимальная полифония", self.poly)
        self.tempo = spin(25, 300, 100)
        self.tempo.setSuffix(" %")
        form.addRow("Темп (сохраняет изменения темпа MIDI)", self.tempo)
        self.transpose = spin(-48, 48, 0)
        form.addRow("Транспонирование композиции", self.transpose)
        self.low_hz = spin(20, self.config['max_frequency'] - 1, self.config["min_frequency"])
        self.high_hz = spin(self.config['min_frequency'] + 1, 1200, self.config["max_frequency"])
        self.low_hz.valueChanged.connect(lambda *_: self.high_hz.setMinimum(self.low_hz.value() + 1))
        self.high_hz.valueChanged.connect(lambda *_: self.low_hz.setMaximum(self.high_hz.value() - 1))
        self.octave = QCheckBox("Переносить недоступные ноты по октавам")
        self.octave.setChecked(True)
        form.addRow(self.octave)
        self.drums = QCheckBox("Разрешить ударный канал (также включите его партию)")
        form.addRow(self.drums)
        root.addWidget(box)
        self.playback_options = box
        row = QHBoxLayout()
        row.addWidget(button("Пересчитать назначения", self.reallocate))
        self.play_button = button("▶ Воспроизвести", self.play, "primary")
        row.addWidget(self.play_button)
        self.pause_button = button("Ⅱ Пауза", self.pause_resume)
        row.addWidget(self.pause_button)
        row.addWidget(button("■ Стоп", lambda: self.player.stop()))
        self.device_slot=QComboBox()
        self.device_slot.addItems(['Место %d'%i for i in range(1,11)])
        row.addWidget(self.device_slot)
        self.device_save_button=button("Сохранить в устройство",self.save_device_song)
        row.addWidget(self.device_save_button)
        row.addStretch()
        root.addLayout(row)
        self.position = QLabel("00:00.000")
        self.device_save_progress=QProgressBar();self.device_save_progress.setRange(0,100)
        self.device_save_progress.setFormat('Сохранение в устройство: %p%');root.addWidget(self.device_save_progress)
        self.device_songs=DeviceSongs(self.client,self)
        self.device_songs.progress.connect(self.device_save_update)
        self.device_songs.finished.connect(self.device_save_done)
        self.device_songs.failed.connect(self.device_save_failed)
        self.position.setStyleSheet("font-size:32px;font-weight:600")
        root.addWidget(self.position)
        self.timeline = QProgressBar()
        self.timeline.setRange(0, 1000)
        root.addWidget(self.timeline)
        queue_row = QHBoxLayout()
        queue_row.addWidget(QLabel("Очередь STM32"))
        self.queue_bar = QProgressBar()
        self.queue_bar.setRange(0, 256)
        queue_row.addWidget(self.queue_bar, 1)
        root.addLayout(queue_row)
        self.play_state = QLabel("Остановлено")
        root.addWidget(self.play_state)
        voices = QHBoxLayout()
        self.voice_labels = []
        for i in range(6):
            label = QLabel("M%d\n—" % (i + 1))
            label.setAlignment(Qt.AlignCenter)
            label.setStyleSheet(
                "background:#1a293d;border-radius:6px;padding:14px;color:%s;font-size:18px"
                % MOTOR_COLORS[i]
            )
            voices.addWidget(label)
            self.voice_labels.append(label)
        root.addLayout(voices)
        self.allocation_label = QLabel()
        self.allocation_label.setWordWrap(True)
        root.addWidget(self.allocation_label)
        root.addStretch()
        for control in (self.poly, self.tempo, self.transpose, self.low_hz, self.high_hz):
            control.valueChanged.connect(self.invalidate_allocation)
        self.strategy.currentIndexChanged.connect(self.invalidate_allocation)
        self.octave.toggled.connect(self.invalidate_allocation)
        self.drums.toggled.connect(self.invalidate_allocation)

    def build_log(self):
        page, root = self.page("UART-журнал")
        self.log = QPlainTextEdit()
        self.log.setReadOnly(True)
        self.log.setMaximumBlockCount(2500)
        root.addWidget(self.log)
        row = QHBoxLayout()
        row.addWidget(button("Очистить", self.log.clear))
        row.addWidget(button("Сохранить журнал", self.save_log))
        row.addStretch()
        root.addLayout(row)

    def build_settings(self):
        page, page_layout = self.page("Настройки")
        scroll = QScrollArea()
        scroll.setWidgetResizable(True)
        content = QWidget()
        content.setMaximumWidth(820)
        root = QVBoxLayout(content)
        root.setSpacing(12)
        scroll.setWidget(content)
        page_layout.addWidget(scroll)
        appearance = QGroupBox("Отображение двигателей")
        appearance_form = QFormLayout(appearance)
        self.motor_layout = QComboBox()
        self.motor_layout.addItem("Горизонтальный", "horizontal")
        self.motor_layout.addItem("Вертикальный", "vertical")
        self.motor_layout.setCurrentIndex(self.motor_layout.findData(self.config.get("motor_layout", "horizontal")))
        self.motor_layout.activated[int].connect(lambda *_: self.change_motor_layout())
        appearance_form.addRow("Вид карточек", self.motor_layout)
        self.note_hold = spin(500, 500, 500)
        self.note_hold.setSuffix(" мс")
        self.note_hold.setSingleStep(50)
        self.note_hold.setToolTip("Паузы до 500 мс сохраняют индикацию, если следующее вступление уже известно.")
        appearance_form.addRow("Скрывать паузы MIDI до", self.note_hold)
        self.low_hz.setSuffix(' Гц')
        self.high_hz.setSuffix(' Гц')
        limits = QHBoxLayout()
        limits.addWidget(QLabel('От'))
        limits.addWidget(self.low_hz)
        limits.addWidget(QLabel('до'))
        limits.addWidget(self.high_hz)
        appearance_form.addRow('Диапазон частоты', limits)
        root.addWidget(appearance)
        self.motor_settings = QGroupBox("Используемые двигатели")
        motor_form = QGridLayout(self.motor_settings)
        for col, title in enumerate(["Использовать", "Название", "Полных шагов / оборот", "Направление"]):
            motor_form.addWidget(QLabel(title), 0, col)
        self.used_settings, self.name_settings, self.direction_settings = [], [], []
        self.step_settings = []
        for i in range(6):
            used = QCheckBox("M%d" % (i + 1))
            used.setChecked(bool(self.config["installed_mask"] & (1 << i)))
            name = QLineEdit(self.config["names"][i])
            name.setMaximumWidth(240)
            w = spin(1, 10000, self.config["steps_per_revolution"][i])
            w.setFixedWidth(115)
            direction = QComboBox()
            direction.setFixedWidth(125)
            direction.addItems(["↻ DIR 0", "↺ DIR 1"])
            direction.setCurrentIndex(self.config["directions"][i])
            self.used_settings.append(used)
            self.name_settings.append(name)
            self.step_settings.append(w)
            self.direction_settings.append(direction)
            for col, widget in enumerate([used, name, w, direction]):
                motor_form.addWidget(widget, i + 1, col)
        root.addWidget(self.motor_settings)
        hint = QLabel("На экране и в распределении нот участвуют только выбранные моторы. Изменения применяются кнопкой ниже.")
        hint.setWordWrap(True)
        root.addWidget(hint)
        playback_group = QGroupBox("Воспроизведение")
        form = QFormLayout(playback_group)
        form.setFieldGrowthPolicy(QFormLayout.FieldsStayAtSizeHint)
        form.setSpacing(10)
        self.lookahead = spin(500, 10000, self.config["lookahead_ms"])
        self.lookahead.setSuffix(" мс")
        self.lookahead.setFixedWidth(115)
        form.addRow("Упреждение музыкального потока", self.lookahead)
        root.addWidget(playback_group)
        audio_group = QGroupBox("Аудио · внешние программы")
        form = QFormLayout(audio_group)
        form.setSpacing(10)
        self.ffmpeg = QLineEdit(self.config.get("ffmpeg", "ffmpeg"))
        self.ffmpeg.setMaximumWidth(410)
        form.addRow("Путь к ffmpeg.exe", self.ffmpeg)
        self.basic_pitch = QLineEdit(self.config.get("basic_pitch_command", ""))
        self.basic_pitch.setMaximumWidth(410)
        form.addRow("Путь к basic-pitch.exe (опционально)", self.basic_pitch)
        root.addWidget(audio_group)
        self.save_settings_button = button("Применить и сохранить настройки", self.persist, "primary")
        root.addWidget(self.save_settings_button, 0, Qt.AlignLeft)
        note = QLabel(
            "Перед ручным запуском снимите общие SLEEP и RESET. Кнопка «Пуск» автоматически включает ENABLE двигателя.\nSTOP ALL останавливает все импульсы и отключает драйверы."
        )
        note.setWordWrap(True)
        root.addWidget(note)
        root.addStretch()

    def refresh_ports(self):
        current = self.ports.currentData() or self.config.get("port", "")
        self.ports.clear()
        for p in list_ports.comports():
            self.ports.addItem("%s · %s" % (p.device, p.description), p.device)
        i = self.ports.findData(current)
        if i >= 0:
            self.ports.setCurrentIndex(i)

    def show_version(self, text):
        self.version.setText(text.split(";")[0])
        self.version.setToolTip(text)

    def toggle_connection(self):
        if self.client.connected:
            self.player.stop()
            self.client.close()
            return
        self.link_error = False
        self.client.connect_device(
            self.ports.currentData() or "",
            int(self.baud.currentText()),
            self.simulation,
        )
        if self.client.connected:
            self.client.send(C.SET_MASK, bytes([self.config["installed_mask"]]))
            self.client.send(C.MICROSTEP, bytes([self.config["microstep_raw"]]))
            for i, direction in enumerate(self.config["directions"]):
                if self.config["installed_mask"] & (1 << i):
                    self.client.send(C.DIR, bytes([i, direction]))

    def on_connection(self, connected):
        self.cancel_direction_restart()
        self.connection_label.setText(
            "● СИМУЛЯТОР"
            if connected and self.client.sim
            else "● UART"
            if connected
            else "○ Отключено"
        )
        self.connect_button.setText("Отключить" if connected else "Подключить")
        self.ports.setEnabled(not connected)
        self.baud.setEnabled(not connected)
        if not connected:
            self.latest_status = None
            self.player.on_fault("Соединение закрыто")
        self.refresh_cards()

    def receive_status_bytes(self, data):
        from protocol.wire import decode_status

        self.on_status(decode_status(data))

    def on_status(self, status):
        self.latest_status = status
        self.link_error = bool(status["error"])
        self.sleep.setChecked(status["sleep"])
        self.reset.setChecked(status["reset"])
        self.queue_bar.setValue(status["used"])
        self.queue_bar.setFormat("%v / 256 событий")
        self.refresh_cards()
        for i, label in enumerate(self.voice_labels):
            m = status["motors"][i]
            label.setText(
                "M%d\n%s\n%s"
                % (
                    i + 1,
                    "%.1f Гц" % m["frequency"] if m["active"] else "—",
                    "STEP ●" if m["active"] else "STEP ○",
                )
            )

    def refresh_cards(self):
        playing = self.player.state in ("preparing", "playing", "paused")
        self.main_play_button.setText({"stopped": "▶ Мелодия", "preparing": "Подготовка…",
                                       "playing": "Ⅱ Пауза", "paused": "▶ Продолжить"}[self.player.state])
        self.main_play_button.setEnabled(self.client.connected and self.player.state != "preparing")
        self.main_stop_button.setEnabled(self.client.connected)
        self.motor_settings.setEnabled(not playing)
        self.save_settings_button.setEnabled(not playing)
        self.low_hz.setEnabled(not playing)
        self.high_hz.setEnabled(not playing)
        for card in self.cards:
            gap_note = None
            if self.client.sim and self.player.state == 'playing' and self.player.allocation:
                gap_note = short_gap_note(self.player.allocation.segments, card.index, self.player.position, 500)
            elif not self.client.sim:
                motor = self.latest_status['motors'][card.index] if self.latest_status else {}
                gap_note = motor.get('note') if motor.get('display_hold') else None
            card.update_status(self.latest_status, self.client.connected, self.link_error, playing,
                               self.player.state == 'playing', gap_note,
                               self.player.allocation.note_range if playing and self.player.allocation else None)
            if self.player.state == 'preparing':
                card.direction.setEnabled(False)
        for i, label in enumerate(self.voice_labels):
            label.setVisible(bool(self.config["installed_mask"] & (1 << i)))
        for control in self.common_manual_controls:
            control.setEnabled(self.client.connected and not playing)
        self.reset_button.setEnabled(self.client.connected)
        self.activate_button.setEnabled(self.client.connected and not playing)

    def manual_command(self, m, command, value):
        self.cancel_direction_restart(m, command == 'direction')
        if not self.config["installed_mask"] & (1 << m):
            return
        if self.player.state in ("playing", "preparing", "paused") and command != "direction":
            if command == "stop":
                self.player.stop()
            return
        if command == "frequency":
            self.client.send(C.FREQUENCY, struct.pack("<BI", m, round(value * 1000)))
        elif command == "note":
            self.client.send(C.NOTE, bytes([m, value]))
        elif command == "enable":
            self.client.send(C.ENABLE, bytes([m, int(value)]))
        elif command == "start":
            self.client.send(C.START, bytes([m]))
        elif command == "stop":
            self.client.send(C.STOP, bytes([m]))
            self.client.send(C.ENABLE, bytes([m, 0]))
        elif command == "direction":
            self.config["directions"][m] = value
            self.direction_settings[m].setCurrentIndex(value)
            self.change_direction(m, value)

    def cancel_direction_restart(self, motor=None, preserve=False):
        if motor is None:
            self.direction_epoch += 1
            self.direction_restart = [False] * 6
        else:
            self.direction_motor_epochs[motor] += 1
            if not preserve:
                self.direction_restart[motor] = False

    def change_direction(self, motor, direction):
        from protocol.wire import decode_status
        epoch = self.direction_epoch
        motor_epoch = self.direction_motor_epochs[motor]
        def valid():
            return epoch == self.direction_epoch and motor_epoch == self.direction_motor_epochs[motor]
        if self.player.state in ('playing', 'paused'):
            resume = self.player.state == 'playing'
            self.player.pause()
            player_epoch = self.player.epoch
            self.player.config['directions'] = list(self.config['directions'])
            def changed(_data):
                if resume and valid() and player_epoch == self.player.epoch:
                    self.player.resume()
            self.client.send(C.DIR, bytes([motor, direction]), callback=changed)
            return
        if self.player.state != 'stopped':
            return

        def stopped_status(data):
            if not valid():
                return
            was_active = decode_status(data)['motors'][motor]['active'] or self.direction_restart[motor]
            self.direction_restart[motor] = was_active
            self.client.send(C.STOP, bytes([motor]))
            def changed(_data):
                if not was_active:
                    return
                ready_at = time.monotonic() + 0.005
                def restart():
                    if (valid() and self.client.connected
                            and self.player.state == 'stopped'):
                        if time.monotonic() < ready_at:
                            QTimer.singleShot(5, restart)
                            return
                        self.direction_restart[motor] = False
                        self.client.send(C.START, bytes([motor]))
                QTimer.singleShot(5, restart)
            self.client.send(C.DIR, bytes([motor, direction]), callback=changed)
        self.client.send(C.GET_STATUS, callback=stopped_status)

    def common_command(self, command, value):
        self.cancel_direction_restart()
        self.client.send(command, b"" if value is None else bytes([int(value)]))

    def reset_drivers(self):
        self.cancel_direction_restart()
        if not self.client.connected:
            return
        self.preview.stop()
        self.player.stop(disable=True)
        self.client.send(C.RESET, b"\x01")
        self.client.send(C.GET_STATUS, callback=self.receive_status_bytes)

    def activate_drivers(self):
        if not self.client.connected or self.player.state != "stopped":
            return
        self.client.send(C.RESET, b"\x00")
        self.client.send(C.SLEEP, b"\x00")
        self.client.send(C.GET_STATUS, callback=self.receive_status_bytes)

    # Read the widget directly: compiled PySide2 callbacks can lose signal arguments.
    def sleep_clicked(self, *_args):
        self.common_command(C.SLEEP, self.sleep.isChecked())

    def reset_clicked(self, *_args):
        self.common_command(C.RESET, self.reset.isChecked())

    def snap_selected(self, *_args):
        self.roll.snap = self.snap.currentData()

    def part_motor_callback(self, part_id, widget):
        def changed(*_args):
            self.assign_part(part_id, widget.currentData())
        return changed

    def part_transpose_callback(self, part_id, widget):
        def changed(*_args):
            self.transpose_part(part_id, widget.value())
        return changed

    def micro_selected(self):
        data = self.micro.currentData()
        if data:
            self.config["microstep"] = data[1]
            self.config["microstep_raw"] = data[0]
            if self.client.connected:
                self.client.send(C.MICROSTEP, bytes([data[0]]))
            self.refresh_cards()

    def motor_config_changed(self):
        old = self.config["installed_mask"]
        self.config["installed_mask"] = sum(
            1 << i for i, used in enumerate(self.used_settings) if used.isChecked()
        )
        self.config["music_mask"] = self.config["installed_mask"]
        self.config["names"] = [w.text() for w in self.name_settings]
        if old != self.config["installed_mask"] and self.client.connected:
            self.client.send(C.SET_MASK, bytes([self.config["installed_mask"]]))
        for i, w in enumerate(self.direction_settings):
            value = w.currentIndex()
            if value != self.config["directions"][i] and self.client.connected and self.config["installed_mask"] & (1 << i):
                self.manual_command(i, "direction", value)
            self.config["directions"][i] = value
        self.layout_motors()
        self.invalidate_allocation()
        self.refresh_cards()

    def layout_motors(self):
        vertical = self.config.get("motor_layout") == "vertical"
        self.motor_grid.setAlignment(Qt.AlignTop if vertical else Qt.Alignment())
        self.fit_motor_height()
        self.midi_overview.setVisible(vertical)
        for row in range(self.motor_grid.rowCount()):
            self.motor_grid.setRowStretch(row, 0)
        for col in range(self.motor_grid.columnCount()):
            self.motor_grid.setColumnStretch(col, 0)
        for card in self.cards:
            self.motor_grid.removeWidget(card)
            card.hide()
            card.name.setText(self.config["names"][card.index])
            card.set_vertical(vertical)
        self.motor_grid.removeWidget(self.no_motors)
        self.no_motors.hide()
        used = [c for c in self.cards if self.config["installed_mask"] & (1 << c.index)]
        columns = max(1, len(used)) if vertical else (3 if len(used) > 4 else min(2, max(1, len(used))))
        for i, card in enumerate(used):
            self.motor_grid.addWidget(card, i // columns, i % columns)
            self.motor_grid.setColumnStretch(i % columns, 1)
            self.motor_grid.setRowStretch(i // columns, 1)
            card.show()
        if not used:
            self.motor_grid.addWidget(self.no_motors, 0, 0)
            self.no_motors.show()

    def fit_motor_height(self):
        if self.config.get("motor_layout") == "vertical":
            self.motor_scroll.setFixedHeight(min(502, max(200, self.height() - 400)))
        else:
            self.motor_scroll.setMinimumHeight(0)
            self.motor_scroll.setMaximumHeight(16777215)

    def resizeEvent(self, event):
        super().resizeEvent(event)
        if hasattr(self, 'motor_scroll'):
            self.fit_motor_height()

    def change_motor_layout(self):
        self.config["motor_layout"] = self.motor_layout.currentData()
        self.layout_motors()
        save_settings(self.config, self.settings_path)

    def set_song(self, song):
        self.main_cursor_ms = 0
        self.preview_cursor_beat = 0.0
        self.preview.stop()
        self.preview.synth = None
        self.preview_progress(0)
        if self.player.state != "stopped":
            self.player.stop()
        self.song = song
        self.allocation = None
        self.allocation_dirty = True
        self.midi_overview.set_allocation(None, self.config['installed_mask'])
        self.roll.set_song(song)
        self.roll.set_playhead(0, -1)
        self.preview_progress(0)
        self.populate_parts()
        self.song_label.setText(song.title)
        self.main_song_label.setText(song.title)
        self.reallocate()

    def populate_parts(self):
        self.loading = True
        self.parts.setRowCount(len(self.song.parts))
        for row, p in enumerate(self.song.parts.values()):
            item = QTableWidgetItem(p.name)
            item.setData(Qt.UserRole, p.id)
            item.setCheckState(Qt.Checked if p.enabled else Qt.Unchecked)
            self.parts.setItem(row, 0, item)
            combo = QComboBox()
            combo.addItem("Авто", -1)
            for i in range(6):
                combo.addItem("M%d" % (i + 1), i)
            combo.setCurrentIndex(p.motor + 1)
            combo.currentIndexChanged.connect(self.part_motor_callback(p.id, combo))
            self.parts.setCellWidget(row, 1, combo)
            trans = spin(-48, 48, p.transpose)
            trans.valueChanged.connect(self.part_transpose_callback(p.id, trans))
            self.parts.setCellWidget(row, 2, trans)
            info = QTableWidgetItem(
                "%d / %d%s" % (p.channel + 1, p.program + 1, " 🥁" if p.percussion else "")
            )
            info.setFlags(info.flags() & ~Qt.ItemIsEditable)
            self.parts.setItem(row, 3, info)
        self.loading = False
        if self.parts.rowCount():
            self.parts.selectRow(0)

    def part_changed(self, item):
        if self.loading or item.column() != 0:
            return
        p = self.song.parts[item.data(Qt.UserRole)]
        p.enabled = item.checkState() == Qt.Checked
        p.name = item.text()
        self.invalidate_allocation()

    def part_selected(self):
        row = self.parts.currentRow()
        if row >= 0:
            self.roll.current_part = self.parts.item(row, 0).data(Qt.UserRole)
            self.roll.refresh_notes()

    def assign_part(self, pid, motor):
        self.song.parts[pid].motor = motor
        self.invalidate_allocation()

    def transpose_part(self, pid, value):
        self.song.parts[pid].transpose = value
        self.invalidate_allocation()

    def split_part(self):
        if self.player.state != "stopped":
            return
        selected = [i.note for i in self.roll.note_items if i.isSelected()]
        if not selected:
            return
        name, ok = QInputDialog.getText(self, "Новая партия", "Название")
        if not ok or not name:
            return
        pid = "group:%d" % len(self.song.parts)
        while pid in self.song.parts:
            pid += "x"
        source = self.song.parts[selected[0].part]
        self.song.parts[pid] = Part(pid, name, source.track, source.channel, source.program, source=source.source)
        before = copy.deepcopy(self.song.notes)
        for n in selected:
            n.part = pid
        self.roll.commit(before, "Новая группа нот")
        self.populate_parts()

    def set_velocity(self):
        if self.player.state != "stopped":
            return
        before = copy.deepcopy(self.song.notes)
        for item in self.roll.note_items:
            if item.isSelected():
                item.note.velocity = self.velocity.value()
        if before != self.song.notes:
            self.roll.commit(before, "Velocity")

    def on_edited(self):
        self.invalidate_allocation()

    def invalidate_allocation(self, *args):
        self.preview.stop()
        self.allocation_dirty = True
        text = 'Есть изменения. Нажмите «Пересчитать распределение». Остальные назначения сохранены.'
        self.update_pin_conflicts()
        if self.roll.conflicts:
            text = 'Красным отмечены пересечения закреплений (%d нот). ' % len(self.roll.conflicts) + text
        self.allocation_label.setText(text)
        self.editor_allocation_status.setText(text)
        for label in (self.allocation_label, self.editor_allocation_status):
            label.setStyleSheet('color:#ff8d99;font-weight:600')

    def update_pin_conflicts(self):
        self.roll.set_conflicts(pin_conflict_spans(
            self.song, self.config['installed_mask'], self.config['music_mask'], self.poly.value()))

    def require_allocation(self):
        if self.allocation is None or self.allocation_dirty:
            self.show_error('Сначала нажмите «Пересчитать распределение». Ручные правки не запускают автомат.')
            return False
        return True

    def reallocate(self):
        if self.player.state != 'stopped':
            return False
        self.preview.stop()
        self.update_pin_conflicts()
        try:
            allocation = allocate(
                self.song,
                self.config["installed_mask"],
                self.config["music_mask"],
                self.poly.value(),
                self.strategy.currentData(),
                self.low_hz.value(),
                self.high_hz.value(),
                self.transpose.value(),
                self.octave.isChecked(),
                self.tempo.value() / 100,
                self.drums.isChecked(),
            )
        except (ValueError, OverflowError) as exc:
            self.allocation_dirty = True
            self.editor_allocation_status.setText(str(exc))
            self.allocation_label.setText(str(exc))
            self.show_error(str(exc))
            return False
        self.allocation = allocation
        self.allocation_dirty = False
        self.editor_allocation_status.setText('Предварительное распределение актуально. При игре моторы назначает контроллер.')
        for label in (self.allocation_label, self.editor_allocation_status):
            label.setStyleSheet('')
        self.roll.set_allocation(self.allocation)
        self.midi_overview.set_allocation(self.allocation, self.config["installed_mask"])
        self.main_cursor_ms = min(self.main_cursor_ms, max(0, self.allocation.duration_ms - 1))
        self.midi_overview.set_position(self.main_cursor_ms)
        available = sum(
            bool(self.config["installed_mask"] & self.config["music_mask"] & (1 << i))
            for i in range(6)
        )
        self.allocation_label.setText(
            "Доступно двигателей: %d · реальная полифония ≤ %d · назначено нот: %d · пропусков / прерываний: %d"
            % (
                available,
                min(available, self.poly.value()),
                len(self.allocation.assignments),
                len(self.allocation.skipped),
            )
        )
        by_id = {n.id: n for n in self.song.notes}
        if self.allocation.skipped:
            self.allocation_label.setStyleSheet('color:#ff8d99;font-weight:600')
            self.allocation_label.setToolTip('Проверьте список пропусков ниже: увеличьте полифонию или число доступных моторов, измените диапазон либо закрепления партий.')
        else:
            self.allocation_label.setToolTip('')
        self.skip_list.setStyleSheet('color:#ff8d99' if self.allocation.skipped else '')
        self.skip_list.setPlainText(
            "\n".join(
                "%s @ %.2f: %s" % (note_name(by_id[uid].pitch), by_id[uid].start, reason)
                for uid, reason in self.allocation.skipped.items()
            )
        )
        return True

    def stop_all(self):
        self.cancel_direction_restart()
        self.preview.stop()
        self.player.stop(True)

    def listen(self):
        if self.player.state != "stopped":
            return
        if self.preview.state == 'paused':
            self.preview.pause_resume()
            return
        if self.listen_mode.currentIndex() == 1 and not self.require_allocation():
            return
        self.preview_speed = self.tempo.value() / 100
        notes = preview_notes(self.song, self.preview_speed, self.transpose.value(),
                              self.allocation if self.listen_mode.currentIndex() == 1 else None)
        start_ms = round(self.song.seconds(self.preview_cursor_beat, self.preview_speed) * 1000)
        self.preview.play(notes, start_ms)

    def toggle_preview(self):
        if self.player.state != 'stopped':
            return
        if self.preview.state == 'playing':
            self.preview.pause_resume()
        else:
            self.listen()

    def set_preview_cursor(self, beat):
        if self.player.state != 'stopped':
            return
        self.preview_cursor_beat = min(self.song.end, max(0, beat))
        ms = round(self.song.seconds(self.preview_cursor_beat, self.tempo.value() / 100) * 1000)
        if self.preview.state != 'stopped':
            self.preview.seek(ms)
        else:
            self.roll.set_playhead(self.preview_cursor_beat, -1)
            self.preview_progress(ms)

    def preview_duration(self):
        if self.preview.state != 'stopped':
            return self.preview.duration_ms
        return round(self.song.seconds(self.song.end, self.tempo.value() / 100) * 1000)

    def seek_preview_slider(self):
        ms = self.listen_seek.value() * self.preview_duration() / 1000
        self.set_preview_cursor(self.song.beat_at(ms / 1000, self.tempo.value() / 100))

    def preview_state(self, state):
        self.listen_button.setEnabled(state != 'playing')
        self.listen_button.setText("▶ Продолжить" if state == 'paused' else "▶ Слушать на ПК")
        self.listen_pause.setEnabled(state == 'playing')
        self.listen_stop.setEnabled(state != 'stopped')
        self.listen_seek.setEnabled(bool(self.song.notes))
        if state == 'stopped':
            self.roll.set_playhead(self.preview_cursor_beat, -1)

    def preview_progress(self, ms):
        duration = self.preview_duration()
        if self.preview.state == 'stopped':
            ms = round(self.song.seconds(self.preview_cursor_beat, self.tempo.value() / 100) * 1000)
        self.listen_seek.setEnabled(duration > 0)
        self.listen_time.setText("%02d:%02d.%03d / %02d:%02d" %
                                 (ms // 60000, ms // 1000 % 60, ms % 1000,
                                  duration // 60000, duration // 1000 % 60))
        if not self.listen_seek.isSliderDown():
            self.listen_seek.setValue(round(1000 * ms / max(1, duration)))
        if self.preview.state != 'stopped':
            self.midi_overview.set_position(ms)
            self.roll.set_playhead(self.song.beat_at(ms / 1000, self.preview_speed),
                                   ms if self.listen_mode.currentIndex() == 1 else -1)

    def device_save_update(self,stage,percent):
        self.device_save_progress.setValue(percent);self.device_save_progress.setFormat(stage+' — %p%')

    def device_save_done(self):
        self.device_save_button.setEnabled(True)
        self.statusBar().showMessage('Мелодия сохранена. Выберите её на экране устройства.',10000)

    def device_save_failed(self,text):
        self.device_save_button.setEnabled(True);self.show_error(text)

    def save_device_song(self):
        if self.player.state!='stopped':
            self.show_error('Остановите воспроизведение перед сохранением');return
        if not self.require_allocation():return
        if not self.allocation.assignments:
            self.show_error('Нет нот для доступных двигателей');return
        self.collect_settings()
        self.device_save_button.setEnabled(False)
        self.device_songs.start(self.allocation,self.song.title,self.device_slot.currentIndex(),self.config)
        if not self.device_songs.active:self.device_save_button.setEnabled(True)

    def play(self):
        if hasattr(self,'device_songs') and self.device_songs.active:
            self.show_error('Дождитесь завершения сохранения');return
        self.cancel_direction_restart()
        self.preview.stop()
        if self.player.state == "paused":
            self.player.resume()
            return
        if self.player.state != "stopped":
            return
        if not self.require_allocation():
            return
        if not self.allocation.assignments:
            self.show_error("Нет нот для доступных двигателей")
            return
        self.collect_settings()
        self.player.play(self.allocation, self.config, self.main_cursor_ms)

    def update_device_screen(self, on_ready=None):
        if self.client.sim:
            if on_ready: on_ready()
            return
        if not self.client.connected or self.device_songs.active:
            return
        if not on_ready and ((self.client.pending and self.client.pending['command'] == C.SCREEN_SONG)
                or any(c[0] == C.SCREEN_SONG for c in self.client.commands)):
            return
        duration = self.allocation.duration_ms if self.allocation else 0
        position = self.player.position if self.player.state != 'stopped' else self.main_cursor_ms
        flags = 1 if self.player.state == 'playing' else 2 if self.player.state == 'paused' else 0
        title = self.song.title.encode('utf-8')[:48].decode('utf-8', 'ignore').encode('utf-8')
        bounds = self.allocation.note_range if self.allocation else None
        payload = struct.pack('<BBIIBB', self.screen_action_ack, flags | 128, int(position), int(duration),
                              *(bounds or (255, 255))) + title
        def accepted(data):
            self.device_screen_action(data)
            if on_ready: on_ready()
        self.client.send(C.SCREEN_SONG, payload, callback=accepted)

    def device_screen_action(self, data):
        if len(data) != 7 or not data[0] or data[0] == self.screen_action_ack:
            return
        self.screen_action_ack = data[0]
        action = data[1]
        if action == 2:
            self.seek_main_cursor(struct.unpack_from('<I', data, 3)[0])
        elif action == 1:
            self.toggle_main_playback()

    def seek_main_cursor(self, ms):
        self.cancel_direction_restart()
        self.preview.stop()
        if self.player.state == 'stopped' and not self.require_allocation():
            return
        self.main_cursor_ms = max(0, min(ms, max(0, self.allocation.duration_ms - 1)))
        self.player.seek(self.main_cursor_ms)
        self.on_progress(self.main_cursor_ms, 0)

    def toggle_main_playback(self):
        if self.player.state == "playing":
            self.pause_resume()
        else:
            self.play()

    def pause_resume(self):
        if self.player.state == "paused":
            self.player.resume()
        else:
            self.player.pause()

    def player_state(self, state):
        self.preview_controls.setEnabled(state == "stopped")
        self.play_state.setText(
            {
                "stopped": "Остановлено",
                "preparing": "Подготовка драйверов и заполнение очереди…",
                "playing": "● Поток воспроизводится",
                "paused": "Ⅱ Пауза, STEP остановлен",
            }[state]
        )
        self.pause_button.setText("▶ Продолжить" if state == "paused" else "Ⅱ Пауза")
        self.play_button.setEnabled(state in ("stopped", "paused"))
        self.playback_options.setEnabled(state == "stopped")
        self.parts.setEnabled(state == "stopped")
        for layout in self.editor_tool_layouts:
            for i in range(layout.count()):
                widget = layout.itemAt(i).widget()
                if widget:
                    widget.setEnabled(state == "stopped")
        self.roll.read_only = state != "stopped"
        if state in ("stopped", "paused"):
            self.roll.position_ms = -1
            self.roll.viewport().update()
        self.refresh_cards()

    def on_progress(self, ms, used):
        self.midi_overview.set_position(ms)
        self.position.setText("%02d:%02d.%03d" % (ms // 60000, (ms // 1000) % 60, ms % 1000))
        self.timeline.setValue(int(1000 * ms / max(1, self.allocation.duration_ms)))
        self.roll.set_playhead(self.song.beat_at(ms / 1000, self.tempo.value() / 100), ms)

    def open_midi(self):
        path, _ = QFileDialog.getOpenFileName(self, "Открыть MIDI", "", "MIDI (*.mid *.midi)")
        if path:
            try:
                self.set_song(load_midi(path))
            except Exception as exc:
                self.show_error(str(exc))

    def song_folder(self):
        return Path(self.config.get('songs_directory') or songs_directory())

    def choose_songs_folder(self):
        folder = QFileDialog.getExistingDirectory(self, "Папка с композициями", str(self.song_folder()))
        if folder:
            self.config['songs_directory'] = folder
            save_settings(self.config, self.settings_path)
            self.refresh_songs_menu()

    def refresh_songs_menu(self):
        menu = self.songs_menu
        menu.clear()
        menu.addAction("Выбрать папку…").triggered.connect(self.choose_songs_folder)
        folder = self.song_folder()
        menu.addAction(str(folder)).setEnabled(False)
        menu.addSeparator()
        try:
            songs = discover_songs(folder)
        except OSError as exc:
            menu.addAction("Не удалось прочитать папку: " + str(exc)).setEnabled(False)
            return
        if not songs:
            menu.addAction("Нет композиций (.mid, .midi, .motor.json)").setEnabled(False)
        for name, path in songs:
            menu.addAction(name).triggered.connect(lambda checked=False, p=path: self.open_library_song(p))

    def open_library_song(self, path):
        try:
            song = load_project(path) if str(path).lower().endswith('.motor.json') else load_midi(path)
        except Exception as exc:
            self.show_error(str(exc)); return
        self.player.stop()
        self.poly.setValue(6)
        self.strategy.setCurrentIndex(self.strategy.findData('stable'))
        self.set_song(song)

    def save_midi(self):
        path, _ = QFileDialog.getSaveFileName(
            self, "Сохранить MIDI", self.song.title + ".mid", "MIDI (*.mid)"
        )
        if path:
            try:
                save_midi(self.song, path)
            except Exception as exc:
                self.show_error(str(exc))

    def export_arrangement(self):
        if not self.require_allocation():
            return
        path, _ = QFileDialog.getSaveFileName(
            self,
            "MIDI с учётом распределения, темпа и транспонирования",
            "motors.mid",
            "MIDI (*.mid)",
        )
        if not path:
            return
        song = Song(title="Motor arrangement")
        for start, end, motor, uid, pitch in self.allocation.segments:
            pid = str(motor)
            if pid not in song.parts:
                song.parts[pid] = Part(pid, self.config["names"][motor], motor, motor, 0)
            if end > start:
                song.notes.append(
                    Note(len(song.notes), pid, start / 500, (end - start) / 500, pitch)
                )
        try:
            save_midi(song, path)
        except Exception as exc:
            self.show_error(str(exc))

    def open_project(self):
        path, _ = QFileDialog.getOpenFileName(
            self, "Открыть проект", "", "Music Motor (*.motor.json)"
        )
        if path:
            try:
                self.set_song(load_project(path))
            except Exception as exc:
                self.show_error(str(exc))

    def save_project(self):
        path, _ = QFileDialog.getSaveFileName(
            self, "Сохранить проект", self.song.title + ".motor.json", "Music Motor (*.motor.json)"
        )
        if path:
            save_project(self.song, path)

    def choose_audio(self):
        path, _ = QFileDialog.getOpenFileName(
            self, "Аудиофайл", "", "Audio (*.wav *.mp3 *.flac *.ogg *.m4a *.aac);;Все файлы (*)"
        )
        if path:
            self.audio_path.setText(path)

    def analyze_audio(self):
        if self.audio_thread:
            return
        path = self.audio_path.text()
        if not Path(path).is_file():
            self.show_error("Выберите существующий аудиофайл")
            return
        self.audio_thread = QThread(self)
        options = dict(
            engine=self.audio_engine.currentData(),
            ffmpeg=self.ffmpeg.text(),
            basic_pitch_command=self.basic_pitch.text(),
            polyphony=self.audio_poly.value(),
            sensitivity=self.sensitivity.value(),
            minimum_duration=self.minimum_duration.value(),
            low_note=self.audio_low.currentData(),
            high_note=self.audio_high.currentData(),
        )
        self.audio_worker = AudioWorker(path, options)
        self.audio_worker.moveToThread(self.audio_thread)
        self.audio_thread.started.connect(self.audio_worker.run)
        self.audio_worker.done.connect(self.audio_done)
        self.audio_worker.failed.connect(self.show_error)
        self.audio_worker.progress.connect(self.audio_progress.setValue)
        self.audio_worker.finished.connect(self.audio_thread.quit)
        self.audio_worker.finished.connect(self.audio_worker.deleteLater)
        self.audio_thread.finished.connect(self.audio_thread.deleteLater)
        self.audio_thread.finished.connect(self.audio_finished)
        self.analyze_button.setEnabled(False)
        self.audio_progress.setValue(0)
        self.audio_thread.start()

    def audio_done(self, song):
        self.audio_song = song
        self.audio_preview.set_song(song)
        self.audio_accept.setEnabled(True)
        self.audio_progress.setValue(100)
        self.statusBar().showMessage(
            "Найдено %d приблизительных нот. Проверьте piano roll." % len(song.notes)
        )

    def audio_finished(self):
        self.audio_thread = None
        self.analyze_button.setEnabled(True)

    def accept_audio(self):
        if self.audio_song:
            self.set_song(self.audio_song.clone())
            self.tabs.setCurrentIndex(1)

    def save_audio_midi(self):
        if self.audio_song:
            path, _ = QFileDialog.getSaveFileName(
                self, "Промежуточный MIDI", "transcription.mid", "MIDI (*.mid)"
            )
            if path:
                save_midi(self.audio_song, path)

    def append_log(self, text):
        self.log.appendPlainText(datetime.datetime.now().strftime("%H:%M:%S.%f")[:-3] + " " + text)

    def show_notice(self, heading, text, hint):
        self.notice_title.setText(heading)
        self.notice_message.setText(str(text))
        self.notice_hint.setText('Что делать: ' + hint)
        self.notice.show()

    def show_error(self, text):
        text = str(text)
        lower = text.lower()
        if 'пересчит' in lower:
            hint = 'Откройте MIDI-редактор и нажмите «Пересчитать распределение», затем повторите действие.'
        elif 'нет нот' in lower:
            hint = 'Проверьте включённые партии и моторы, диапазон частот и пересчитайте распределение.'
        elif 'сохранени' in lower and ('дожд' in lower or 'заверш' in lower):
            hint = 'Дождитесь завершения сохранения в устройство, затем повторите действие.'
        elif 'остановите' in lower:
            hint = 'Нажмите «Стоп», дождитесь остановки и повторите действие.'
        elif any(word in lower for word in ('ack', 'uart', 'соединени', 'подключ', 'port', 'порт', 'access', 'доступ')):
            hint = 'Проверьте кабель и COM-порт, закройте другие программы с этим портом и подключитесь заново. Подробности — в UART-журнале.'
        elif 'аудиофайл' in lower:
            hint = 'Во вкладке «Импорт аудио» выберите существующий файл и повторите анализ.'
        else:
            hint = 'Проверьте указанные в сообщении данные или настройки и повторите действие. Если причина неясна, скопируйте сообщение и UART-журнал.'
        self.show_notice('Ошибка / действие не выполнено', text, hint)
        self.link_error = True
        self.statusBar().showMessage("Ошибка: " + text, 20000)
        if hasattr(self, "log"):
            self.append_log("ERROR " + text)
        if hasattr(self, "cards"):
            self.refresh_cards()

    def save_log(self):
        path, _ = QFileDialog.getSaveFileName(self, "Сохранить журнал", "uart.log", "Log (*.log)")
        if path:
            Path(path).write_text(self.log.toPlainText(), encoding="utf8")

    def collect_settings(self):
        self.config.update(
            port=self.ports.currentData() or "",
            baudrate=int(self.baud.currentText()),
            steps_per_revolution=[w.value() for w in self.step_settings],
            lookahead_ms=self.lookahead.value(),
            note_hold_ms=self.note_hold.value(),
            ffmpeg=self.ffmpeg.text(),
            basic_pitch_command=self.basic_pitch.text(),
            min_frequency=self.low_hz.value(),
            max_frequency=self.high_hz.value(),
            max_polyphony=self.poly.value(),
            strategy=self.strategy.currentData(),
            disable_after_stop=True,
        )

    def persist(self):
        self.collect_settings()
        self.motor_config_changed()
        save_settings(self.config, self.settings_path)
        self.refresh_cards()
        self.statusBar().showMessage("Настройки сохранены", 3000)

    def closeEvent(self, event):
        if self.audio_thread:
            self.show_notice('Предупреждение', 'Аудиоанализ ещё выполняется.',
                             'Дождитесь окончания анализа, затем закройте Studio.')
            event.ignore()
            return
        self.preview.stop()
        self.player.stop(True)
        self.client.close()
        self.persist()
        event.accept()
