Coal56AB/music_motor/firmware/Core/Inc/main.h

#define M4_DIR_Pin GPIO_PIN_4
#define M4_DIR_GPIO_Port GPIOA
#define M5_ENABLE_Pin GPIO_PIN_5
#define M5_ENABLE_GPIO_Port GPIOA
#define M4_STEP_Pin GPIO_PIN_6
#define M4_STEP_GPIO_Port GPIOA
#define M5_STEP_Pin GPIO_PIN_7
#define M5_STEP_GPIO_Port GPIOA
#define M5_DIR_Pin GPIO_PIN_0
#define M5_DIR_GPIO_Port GPIOB
#define M6_ENABLE_Pin GPIO_PIN_1
#define M6_ENABLE_GPIO_Port GPIOB
#define M4_ENABLE_Pin GPIO_PIN_2
#define M4_ENABLE_GPIO_Port GPIOB
#define M6_STEP_Pin GPIO_PIN_10
#define M6_STEP_GPIO_Port GPIOB
#define MS3_Pin GPIO_PIN_11
#define MS3_GPIO_Port GPIOB
#define M6_DIR_Pin GPIO_PIN_12
#define M6_DIR_GPIO_Port GPIOB
#define MS2_Pin GPIO_PIN_13
#define MS2_GPIO_Port GPIOB
#define MS1_Pin GPIO_PIN_15
#define MS1_GPIO_Port GPIOB
#define SLEEP_Pin GPIO_PIN_8
#define SLEEP_GPIO_Port GPIOA
#define M1_DIR_Pin GPIO_PIN_11
#define M1_DIR_GPIO_Port GPIOA
#define RESET_Pin GPIO_PIN_12
#define RESET_GPIO_Port GPIOA
#define M1_STEP_Pin GPIO_PIN_15
#define M1_STEP_GPIO_Port GPIOA
#define M1_ENABLE_Pin GPIO_PIN_3
#define M1_ENABLE_GPIO_Port GPIOB
#define M3_DIR_Pin GPIO_PIN_4
#define M3_DIR_GPIO_Port GPIOB
#define M2_ENABLE_Pin GPIO_PIN_5
#define M2_ENABLE_GPIO_Port GPIOB
#define M3_STEP_Pin GPIO_PIN_6
#define M3_STEP_GPIO_Port GPIOB
#define M2_STEP_Pin GPIO_PIN_7
#define M2_STEP_GPIO_Port GPIOB
#define M2_DIR_Pin GPIO_PIN_8
#define M2_DIR_GPIO_Port GPIOB
#define M3_ENABLE_Pin GPIO_PIN_9
#define M3_ENABLE_GPIO_Port GPIOB
