Coal56AB/music_motor/firmware/Core/Src/main.c

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
/* Includes ------------------------------------------------------------------*/
#include "main.h"

/* USER CODE BEGIN Includes */
#include "engine.h"
#include "platform.h"
#include "protocol.h"
/* USER CODE END Includes */

TIM_HandleTypeDef htim2;
TIM_HandleTypeDef htim3;
TIM_HandleTypeDef htim4;

UART_HandleTypeDef huart1;

void SystemClock_Config(void);
static void MX_GPIO_Init(void);
static void MX_TIM2_Init(void);
static void MX_TIM3_Init(void);
static void MX_TIM4_Init(void);
static void MX_USART1_UART_Init(void);
/* USER CODE BEGIN 0 */
static void watchdog_window(uint32_t prescaler, uint32_t reload)
{
  IWDG->KR = 0xAAAAu;
  IWDG->KR = 0x5555u;
  IWDG->PR = prescaler;
  IWDG->RLR = reload;
  while (IWDG->SR != 0u) {
    /* No refresh here: a stuck peripheral must also trigger recovery. */
  }
  IWDG->KR = 0xAAAAu;
}
static void watchdog_start(void)
{
  /* Independent LSI; pause only when halted by a debugger. */
  DBGMCU->CR |= DBGMCU_CR_DBG_IWDG_STOP;
  IWDG->KR = 0xCCCCu;
  /* /16 * 500 / 40 kHz = 200 ms: covers the 100 ms HSE timeout. */
  watchdog_window(2u, 499u);
}

/* USER CODE END 0 */

/**
  * @brief  The application entry point.
  * @retval int
  */
int main(void)
{

  /* USER CODE BEGIN 1 */
  watchdog_start();
  /* USER CODE END 1 */

  /* MCU Configuration--------------------------------------------------------*/

  /* Reset of all peripherals, Initializes the Flash interface and the Systick. */
  HAL_Init();

  /* USER CODE BEGIN Init */
  /* Establish safe driver levels before waiting for the external oscillator. */
  platform_safe_gpio();
  /* USER CODE END Init */

  /* Configure the system clock */
  SystemClock_Config();

  /* Initialize all configured peripherals */
  MX_GPIO_Init();
  MX_TIM2_Init();
  MX_TIM3_Init();
  MX_TIM4_Init();
  MX_USART1_UART_Init();
  /* USER CODE BEGIN 2 */
  platform_init();
  /* Both UARTs are initialized. Restore the normal main-loop watchdog. */
  watchdog_window(4u, 0xFFFu); /* ~6.55 s at nominal 40 kHz LSI. */
  engine_init();
  protocol_init();
  /* USER CODE END 2 */

  /* Infinite loop */
  /* USER CODE BEGIN WHILE */
  while (1)
  {
    /* USER CODE END WHILE */

    /* USER CODE BEGIN 3 */
    protocol_poll();
    engine_tick();
    /* Only a completed main-loop iteration proves the application is alive.
     * Never refresh from SysTick, UART IRQs or Error_Handler. */
    IWDG->KR = 0xAAAAu;
  }
  /* USER CODE END 3 */
}

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
