Coal56AB/music_motor/desktop/build_nuitka.py

"""Build a standalone Windows executable with CPython 3.7 and Nuitka."""
import subprocess
import sys
import shutil
from pathlib import Path


def main():
    root = Path(__file__).resolve().parents[1]
    command = [
        sys.executable, '-m', 'nuitka',
        '--standalone', '--onefile', '--enable-plugin=pyside2',
        '--include-qt-plugins=platforms,styles,imageformats,audio,mediaservice',
        '--windows-console-mode=disable', '--msvc=latest',
        '--assume-yes-for-downloads', '--jobs=2',
        '--include-data-files=desktop/config.json=config.json',
        '--include-package-data=imageio_ffmpeg',
        '--output-dir=_service/build/nuitka',
        '--output-filename=MusicMotorStudio.exe', 'desktop/run.py',
    ]
    subprocess.run(command, cwd=str(root), check=True)
    destination = root / 'MusicMotorStudio.exe'
    shutil.copy2(str(root / '_service/build/nuitka/MusicMotorStudio.exe'), str(destination))
    print(destination)


if __name__ == '__main__':
    main()
