Coal56AB/music_motor/(commit log)

2026-09-10 заработало, с компа может играть
2026-09-10 Добавлен USB-MIDI интерфейс на ESP32-S3 для шести двигателей
2026-09-10 добавлен дисплей и обновлен cmd
2026-09-10 Сделана общение между стм и есп с дисплеем. МИДИ и прочее тоже перенесены в есп дисплей. Доработано принятие миди файлов, передача и сохранение мелодий в память и много чего еще по мелочи
2026-09-11 Доработаны MIDI-редактор и дисплей, добавлена автономная сборка MusicMotorStudio через Nuitka
    Добавлены ручное закрепление нот за моторами, отдельный пересчёт распределения, Undo/Redo и отображение конфликтов. Доработана обработка аккордов и Sustain, сохранение исходных нот и MIDI-контроллеров, проекты и экспорт для моторов. Количество мест для мелодий увеличено до десяти, улучшены передача диапазо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
2026-09-13 Музыкальная логика перенесена на STM32, доработаны редактор и дисплей
    Выбор нот, распределение по моторам, Sustain и сглаживание индикации выполняются на STM32. Доработаны передача MIDI-событий, буферизация воспроизведения и обмен с ESP32. В MusicMotorStudio добавлены библиотека композиций, примеры мелодий и сообщения об ошибках, улучшены работа курсора и ручное управление. Обновлены прошивка STM32, п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
    [happy_birthday.motor.json, imperial_march.motor.json, od.motor.json, playing_god.motor.json, rachmaninoff_op23_5.motor.json, rachmaninoff_op3_2.motor.json]
